the-snowpear/fridge_spirit/doc/野火小智【姿态传感器_MPU6050】模块_20260206/2-配套例程_接线说明/野火小智STM32F103C8核心板/HAL库/3.上位机显示DMP解算/Doc/readme.txt

/*********************************************************************************************/
【*】程序简介

-工程名称：MPU-6050使用上位机
-实验平台: 野火小智 STM32 F103C8T6 核心板

使用MPU-6050采集加速度、角速度、欧拉角等数据，并上传到“匿名上位机”进行姿态显示

/*********************************************************************************************/
【*】实验操作与注意事项：

实验操作

1.核心板掉电情况下，将模块引出脚按照xxx引脚连接说明.xlsx，接到板子对应脚上
2.确保引脚对应接上的情况下，核心板上电，将例程编译成功后，下载到核心板里
3.核心板的USB转串口通过数据线连接电脑，同时确保电脑安装了串口驱动并能识别到核心板的串口
4.电脑端使用串口调试助手，选择电脑与核心板相连的COM口，设置为115200-N-8-1并打开
5.复位核心板，即可接收核心板串口发送给电脑的数据
6.查看串口调试助手打印的提示信息
7.但是本次实验不能直接通过查看串口助手打印的数据来得到有效信息，因为用到了上位机——“匿名上位机V7”，串口传来的数据都根据上位机的数据协议包装过的，
代码烧录完成后，连接串口至电脑端，在文件夹.\1-硬件资料_参考资料_模块手册\例程工具上位机中可以找到 匿名上位机V7.exe，
双击打开软件，可以看见有四个大的板块，分别为：基本收发、协议解析、数据波形、飞控数据，
复位核心板，待LED闪烁后，点击右下角的“连接设置”配置串口的相关参数，串口号直接使用自己的相应串口号即可（可以通过设备管理器查看），波特率实验例程设置的是115200，
配置完成后点击右下角的“打开连接”，当查看到接收计数有增长时，随后点击右下角“功能界面”后面的第四个图标（类似于一个小飞机），也就是飞控数据，可以看到左侧有个3D无人机，右侧是各项参数，
至此就可以看到3D无人机和右侧数据根据MPU6050的姿态变化而变化

注意事项
1.本程序必须配合“匿名上位机V7”使用！！串口向上位机传输的是数据包，所以直接用串口调试助手看是乱码，这是正常的！！
2.MDK工程配置C/C++选项中必须勾选“C99 Mode”选项(本工程默认已勾选，MDK默认不勾选的)
3.因为没加磁力计，六轴MPU6050在Z轴上的测量信息并不准确，同时因为不能完整的使用XYZ三个轴，可能导致Z轴的误差越来越大
4.MPU6050的AD0引脚默认接GND，地址为0x68 ,当接3V3时，地址改为0x69，可在mpu6050.h文件修改宏MPU6050_SLAVE_ADDRESS的值来匹配硬件连接
5.默认使用软件I2C，可在mpu6050.h文件中注释掉#define  soft_IIC使用硬件I2C

/*********************************************************************************************/
【*】引脚分配

MPU-6050：

		3V3 <--->3V3
		GND	<--->GND
		SDA	<--->PB11
		SCL	<--->PB10
		INT <--->PA11
		AD0 <--->GND

LED：
        LED1<--->PA1
        LED2<--->PA2
        LED3<--->PA3
		
串口（TTL-USB TO UART）：
CH340的收发引脚与STM32的发收引脚相连
        CH340  RXD  <--->  USART1  TX  (PA9)
        CH340  TXD  <--->  USART1  RX  (PA10)

/*********************************************************************************************/
【*】联系我们

-野火官网  :https://embedfire.com
-野火论坛  :http://www.firebbs.cn
-野火天猫  :https://yehuosm.tmall.com
-野火京东  :https://yehuo.jd.com/
-野火资料下载中心 :https://doc.embedfire.com/products/link/

/*********************************************************************************************/
