the-snowpear/fridge_spirit/doc/P4_TR230S_SPI4WIRE_FT6336U接线方案.md

# ESP32-P4 CB V1.2 → TR230S SPI-4WIRE + FT6336U 接线方案

> **已停用（2026-07-11）**：同一块屏幕在 S3 上实际验证的是 QSPI-4SDA，接口模式由屏内 IM0/IM1 硬件配置决定。本方案不再用于上电测试，请改用 `doc/P4_TR230S_QSPI_FT6336U接线方案.md`。

适用硬件：慧勤智远 ESP32-P4 CB V1.2、TS040HDS02CP-B1620A（TR230S + FT6336U）、20-pin FPC 转 20 路杜邦线转接板。

> 严禁把屏幕 FPC 直接插进开发板板载 20-pin SPI 屏座。两者电源脚顺序不同，直插会把 5V 接到屏幕 GND。板载 20-pin 屏座保持空置，本方案只把 FPC 转接板的每一路单独接到开发板底部 GPIO 排针。

## 逐脚接线表

开发板一栏使用实板丝印（`07` 表示 GPIO7），不使用原理图连接器代号。FPC Pin 1 必须按转接板丝印或万用表通断确认，不能凭排线正反面猜测。

| FPC Pin | 屏幕信号 | 接开发板丝印 | GPIO | 说明 |
| ---: | --- | --- | ---: | --- |
| 1 | GND | `GND` | — | 公共地 |
| 2 | VCC | `5V` | — | 屏幕主电源，只能接 5V |
| 3 | GND | `GND` | — | 公共地 |
| 4 | CS# | `07` | 7 | SPI 片选，低有效 |
| 5 | GND | `GND` | — | 公共地 |
| 6 | SDO1 / MISO | `10` | 10 | 屏幕到主控；当前驱动只写，但按规格保留连接 |
| 7 | SDO0 / MOSI | `08` | 8 | 主控到屏幕 |
| 8 | SCL / SPI_CLK | `09` | 9 | SPI Mode 0，首次 10 MHz |
| 9 | SDO3 | **不接** | — | 仅 QSPI 使用 |
| 10 | SDO2 | **不接** | — | 仅 QSPI 使用 |
| 11 | RESET# | `22` | 22 | 屏幕复位，低有效 |
| 12 | WAIT# | `19` | 19 | 屏幕忙状态；高电平才允许发送命令 |
| 13 | QSPI-INT / HOST | **不接** | — | 主控直接读 FT6336U，不走 TR230S 触摸代理 |
| 14 | D/C# | `20` | 20 | 低=命令，高=参数/像素 |
| 15 | TP-INT | `15` | 15 | FT6336U 触摸中断 |
| 16 | TP-SDA | `17` | 17 | 触摸 I²C SDA；注意不是 GPIO16 |
| 17 | TP-SCL | `16` | 16 | 触摸 I²C SCL；注意不是 GPIO17 |
| 18 | TP-RST | `18` | 18 | 触摸复位，低有效 |
| 19 | TP-VCC | **不接、悬空** | — | 模组规格标注 `NC (Shared screen power supply)`；禁止接 5V |
| 20 | TP-GND | `GND` | — | 触摸公共地 |

FPC Pin 1、3、5、20 都是 GND。建议在面包板或转接板公共地排汇合，再用至少两根短 GND 线接开发板的两个 `GND`，降低屏幕电流和 SPI 回流造成的地弹噪声。

## I²C 上拉与线长

- `TP-SDA` 和 `TP-SCL` 各接一只 `4.7 kΩ` 电阻到开发板 `3V3`；如果转接板已经带 3.3V 上拉，不重复并联。
- 上拉只能到 `3V3`，不能到 `5V`。`TP_VCC` 保持悬空与 I²C 上拉是两件事。
- 杜邦线尽量不超过 10 cm，SPI 时钟、MOSI、D/C、CS 和相邻 GND 尽量短。
- 首次测试固定 SPI Mode 0 / 10 MHz、触摸 I²C 100 kHz；稳定前不提速。

## 上电顺序

1. 完全断电并拔掉 USB；确认开发板板载 20-pin 屏座为空。
2. 用万用表逐线核对“FPC Pin → 转接板端子 → 杜邦线末端”，尤其确认 Pin 1、Pin 2 和 Pin 19。
3. 检查 5V 与 GND 不短路，各 GPIO 不与 5V 短路；确认所有地共地。
4. 接好后使用稳定 5V/2A 供电。出现异味、异常发热、反复复位或电压塌陷立即断电。
5. 固件日志应先出现 `TR230S display ready`，触摸应出现 `FT6336U ready addr=0x48`；触摸屏时串口打印按下/抬起坐标。

当前 P4 最小固件只用静态色带与串口坐标验证显示/触摸硬件，尚未把旧 S3 的完整 LVGL 页面迁移到 P4。
