the-snowpear/fridge_spirit/ui-reference/ver2/README.md

# 冰箱小精灵 ver2 · UI 参考预览（ESP32-P4 · 横/竖双模式）

本目录是「冰箱小精灵」下一代设备 UI 的**网页参考预览**，完整实现 `doc/` 规划文档定义的
**30 个页面模板 + 12 个全局浮层 + 8 种状态侧舱情境（CTX）**，供设计走查与固件 LVGL
实现对照使用。

- 目标设备：慧勤智远 ESP32-P4 CB V1.2 + 7 寸 1024×600 MIPI-DSI 横屏 + GT911 触摸
- **双模式外壳**（同一套页面/浮层，仅外壳重排）：
  - **横屏标准** `1024×600`：主区 704 | 导航 72 | 状态舱 248（摄像头可用）
  - **竖屏隐私** `600×1024`：上主区 672 / 中导航 64 / 下状态舱 288（**绑定隐私模式，摄像头关闭**；底舱为顶状态条 + 紧凑 CTX）
- 固件 GUI：LVGL 9.2.2（RGB565），字库角色 18/22/28/36/48/64（TF 卡字体包 + FreeType 回退）
- 权威输入：`doc/冰箱小精灵_ESP32-P4_LVGL页面架构与交互规划_V1.0.md`、
  `doc/冰箱小精灵_UI页面路由与状态清单_V1.0.json`、`doc/冰箱小精灵_页面样式设计交接提示词_V1.0.md`
- 视觉风格：暖色 + 鼠尾草绿（延续 ver1 调色板；布局为 ver2 全新三栏壳，与 ver1 方屏无关）
- Web 运维面板：侧栏 **UI 预览** 可 iframe 嵌入本目录，并切换横/竖（Vite 路径 `/ui-ver2/`）

---

## 一、打开方式

**直接双击 `index.html`** 即可（零依赖：无构建、无 ES Module、无 fetch、无 CDN、无网络字体，
`file://` 下完全可用）。也可以起本地服务：

```bash
cd ui-reference/ver2
python -m http.server 8000     # 然后访问 http://localhost:8000
```

或从项目 Web 面板进入：

```bash
cd web
npm run dev
# 浏览器打开面板 → 侧栏「UI 预览」→ 切换「横屏标准 / 竖屏隐私」
```

Query 深链（供 iframe / 书签）：

- `index.html?layout=landscape` 横屏标准
- `index.html?layout=portrait` 竖屏隐私

推荐 Chrome / Edge 最新版。断网可开，控制台应无任何错误。

## 二、预览工具栏（设备框之外，不属于设备 UI）

| 区 | 控件 | 说明 |
| --- | --- | --- |
| 第一行 | 设备预览 / 页面总览 | 设备预览 = 1:1 交互原型；页面总览 = 全部页面/浮层/CTX 缩略图墙 |
| | **布局：横屏标准 / 竖屏隐私** | 切换外壳；竖屏 = 隐私模式（关摄像头） |
| | 页面下拉 + ‹ › | 按模块分组的页面跳转，按规范顺序翻页 |
| | 状态 | 正常 / 加载中 / 空 / 离线 / 错误 / 待确认 / 冲突（六态演示，作用于当前页的异步内容区） |
| | 侧舱 | 自动跟随 或手动锁定 CTX-01..08 |
| | 缩放 | 适应窗口 / 100%（100% 时舞台精确对应当前布局物理像素） |
| | 页面角标 | 页头显示 INV-01 这类规范 ID（默认开，便于与 JSON 清单对照） |
| | 返回 | 先关浮层 → 模块内上一级 → 模块根页（同 Esc 键） |
| 第二行 | OV 触发按钮 ×12 | 逐个演示 12 个全局浮层（标注"阻"= 阻塞型） |
| | 流程演示 ×5 | 拍照登记 / 语音登记 / Agent 高风险确认 / 烹饪+计时 / 安全告警，「停止演示」随时中断；**竖屏下「拍照登记」禁用** |

设备内可真实交互：侧导航切模块、INV-01 空间/列表切换与三级下钻、食材行进详情、
对话工具卡进 CHAT-03、烹饪模式上下步、定时器中心、设置分区切换等。

## 三、目录结构

```
ver2/
├── index.html              # 唯一入口（工具栏 + 设备舞台 + 浮层根 + 按序加载脚本）
├── README.md               # 本文档
├── doc/                    # 规划文档（只读输入，未改动）
├── styles/
│   ├── tokens.css          # 设计令牌（色板/字号/间距/圆角/触控尺寸）
│   ├── base.css            # reset / 设备舞台 / 横竖外壳 / 页面骨架 / 工具栏
│   ├── components.css      # 通用组件（对应 js/core/ui.js 的 builder）
│   ├── cabin.css           # 状态侧舱 + CTX-01..08 + 竖屏底舱
│   ├── overlays.css        # OV-01..12 浮层
│   ├── gallery.css         # 页面总览缩略图墙
│   └── pages-<模块>.css     # 各页面模块独有布局（含竖屏窄主区覆盖）
└── js/
    ├── core/               # icons / ui / mode(横竖+隐私) / router / shell / cabin
    │                       # overlays / states / flows / gallery
    ├── data/mock-data.js   # 全量 mock 数据（演示"今天"= 2026-07-22）
    └── pages/pages-<模块>.js # 系统/首页/库存/对话/计划/更多 六个模块的页面注册与流程
```

架构约定：所有 JS 挂 `window.FS`；页面 = 注册表项 + `render(pg)` 渲染函数（返回 HTML 字符串，
与 LVGL"页面容器 + 子对象树"同构）；路由 `#/p/<页面ID>?参数`（file:// 安全、可刷新、可深链）；
侧导航切模块始终进入该模块一级页（不恢复上次子页现场）；侧舱是独立状态机，不随主页面重建。
布局模式 `FS.mode`：`landscape` / `portrait`；`portrait` 强制 `isPrivacy()===true`。

### 竖屏隐私规则（必须可见）

- 状态舱显示 **隐私模式** 芯片；健康区摄像头图标为 `off`。
- 拍照按钮改为「摄像头关」（禁用态），点击 toast 说明。
- 路由拦截 `INV-05` / `INV-06`；流程「拍照登记」不可启动。
- 横屏模式行为与原先完全一致（含拍照登记）。

## 四、设计令牌（styles/tokens.css）

### 色板（设备内一律纯色平铺，RGB565 友好）

| 令牌 | 值 | 用途 |
| --- | --- | --- |
| `--paper` | `#fffdf8` | 主背景（米白纸面） |
| `--surface` | `#ffffff` | 卡片面 |
| `--cream` | `#fff5e5` | 次级填充 / 侧舱底 |
| `--sage` | `#5f8f72` | 主色：按钮 / 选中 |
| `--sage-dark` | `#2f6047` | 深主色：强调文字 / 侧导航底 |
| `--mint` | `#dcefdc` | 浅绿填充 / 选中底 |
| `--tomato` | `#d95745` | 强调红：危险 / 过期 |
| `--yolk` | `#f6bf4f` | 蛋黄：警示（配深字 `--warn-ink #6b4e00`） |
| `--ink` | `#24342d` | 主文字 |
| `--muted` | `#758078` | 次要文字 |
| `--line` | `rgba(47,96,71,.18)` | 分隔线 / 描边 |
| 语义浅底 | `#dcefdc / #fdeecd / #f9e2de / #eceeed / #e2edf5` | ok / warn / danger / offline / info 五档 chip·banner 底 |

### 字号 / 间距 / 圆角 / 触控

| 项 | 值 | 说明 |
| --- | --- | --- |
| 字号 | **18 / 22 / 28 / 36 / 48 / 64** | 严格对应固件 font_manager 六档字库角色，禁止其他值 |
| 间距 | 4 / 8 / 12 / 16 / 24 / 32 | 4 的倍数 |
| 圆角 | ≤8px（胶囊 = 全圆角） | LVGL 友好 |
| 触控 | 最小 48px；导航/侧舱大按钮 64px | 规划文档要求 44–48px 起 |
| 外壳（横） | 主区 704 + 侧导航 72 + 状态侧舱 248 = 1024；高恒 600 | 系统页隐藏导航（主区 776），OV-10 全屏接管 |
| 外壳（竖） | 宽 600；高 = 主区 672 + 导航 64 + 状态舱 288 = 1024 | 竖屏 = 隐私模式；底舱顶条+紧凑 CTX；系统页隐藏导航 |

## 五、组件 → LVGL 映射

| 预览组件（class） | 用途 | LVGL 对应 |
| --- | --- | --- |
| `.btn` / `.icon-btn` | 操作按钮 | `lv_btn` + 样式 |
| `.card` / `.stat-card` | 信息卡 / 统计卡 | `lv_obj` 圆角容器 |
| `.list-row` / `.food-row` | 列表行 / 食材行 | `lv_obj` 行（LV_FLEX） |
| `.chip` / `.days-pill` | 标记 / 剩余天数 | `lv_obj` + `lv_label` |
| `.seg` | 分段选择（空间/列表、日/周） | `lv_obj` 分段（互斥选中） |
| `.badge` / `.status-dot` | 角标 / 状态点 | `lv_label` 圆底 / `lv_obj` 小圆 |
| `.crumb` | 路径面包屑 | `lv_label` 行 |
| `.zone-map` / `.layer-card` | L1 分区图 / L2 层卡（共用 `.tone-*` 语义底色 + `.sp-bar` 色条） | `LV_GRID` / `lv_obj` 行 |
| `.grid9-board` / `.g9-cell` | L3 九宫格（ver1 风格：一块大圆角板 + 发丝线切九格） | 一个 `lv_obj`（圆角+裁剪）+ 九个子 `lv_obj`，分隔线用子对象右/下 1px 边框 |
| `.g9-expire` | 格内到期条（颜色 = 该格最紧急项的剩余天数档） | `lv_obj` 圆角条 + `lv_label` |
| `.fridge-box` | 冰箱内胆外框（包住当前层级的空间，顶部给范围汇总） | `lv_obj` 容器 + 标题行 |
| `.inv-lay-grid` / `.inv-name-panel` | INV-08 分区形状画布 / 命名面板 | `LV_GRID` / 页面内子容器 |
| `.chat-bubble` / `.tool-card` / `.result-card` | 对话流 | `lv_obj` 容器族 |
| `.recipe-card` / `.menu-slot` | 菜谱 / 餐次 | `lv_obj` 族 |
| `.timer-face-sm` / `.ctx-timer-face` | 计时数字 | `lv_label` + `lv_timer` 局部刷新 |
| `.form-row` / `.switch` / `.stepper` / `.input-like` | 表单 | `lv_obj` / `lv_switch` / `lv_btn` |
| `.kb` / `.roller` | 软键盘 / 滚轮选择器 | `lv_keyboard` / `lv_roller` |
| `.skeleton` / `.empty-state` / `.notice-bar` / `.conflict-box` | 异步状态 | 静态灰块 / `lv_obj`+`lv_label`（固件不做 shimmer 动画） |
| `.kaomoji`（SYS-03） | 待机颜文字 | `lv_label` 大字（纯文本，不依赖图片资源） |
| `.health-icon` / `.ctx-panel` | 侧舱健康图标 / CTX 面板 | `lv_obj` + 小图标 |
| `.scrim` / `.toast` / `.dialog` / `.sheet` | 浮层基元 | `lv_obj` 顶层 + `bg_opa` |
| `.img-ph` | 图片占位块 | TF 卡图片缺失时的占位 `lv_obj` |

## 六、页面 / 浮层 / 侧舱清单（与 JSON 清单逐项对应）

### 30 个页面模板

| 模块 | 页面 |
| --- | --- |
| 系统（3） | SYS-01 启动与自检 · SYS-02 首次配网与设备绑定向导（4 步）· SYS-03 待机颜文字 |
| 首页（2） | HOME-01 首页 · HOME-02 今日摘要详情 |
| 库存（7） | INV-01 库存浏览器（空间/列表双视图，L1 分区→L2 层→L3 九宫格，单模板）· INV-03 食材详情 · INV-04 新增/编辑食材 · INV-05 拍照取景与拍摄 · INV-06 识别结果确认 · INV-07 搜索与筛选结果 · INV-08 空间形状编辑（按入口层级打开分区、指定分区的层、指定层设置三个独立页，画布点选+草稿提交） |
| 对话（4） | CHAT-01 对话主页面 · CHAT-02 会话历史 · CHAT-03 工具执行详情 · CHAT-04 待确认行动 |
| 计划（6） | PLAN-01 计划总览 · PLAN-02 日/周菜单 · PLAN-03 菜谱库 · PLAN-04 菜谱详情 · PLAN-05 烹饪模式 · PLAN-06 购物清单 |
| 更多（8） | MORE-01 更多入口（可滚动）· MORE-02 定时器 · MORE-03 定时器/闹钟编辑 · MORE-04 设备与厨房安全 · MORE-05 设置中心 · MORE-06 维护中心 · MORE-07 闹钟 · MORE-08 秒表 |

### 12 个全局浮层

OV-01 轻提示 Toast（非阻塞，2.5s 自消）· OV-02 顶部/区域通知条（非阻塞）·
OV-03 通用确认框（**阻塞**）· OV-04 Agent 高风险操作确认（**阻塞**）·
OV-05 语音聆听与转写层 · OV-06 Agent 处理状态层 · OV-07 拍照上传与识别进度 ·
OV-08 同步/离线状态层 · OV-09 定时器/闹钟到时层 · OV-10 关键安全告警（**阻塞 + 全屏接管，P0**）·
OV-11 快速添加面板 · OV-12 软键盘/数值与日期选择器（**阻塞**，停靠主区底部）

### 8 种状态侧舱情境（CTX）

CTX-01 默认/首页 · CTX-02 库存 · CTX-03 语音 · CTX-04 拍照识别 ·
CTX-05 Agent 执行 · CTX-06 计划/烹饪 · CTX-07 定时器 · CTX-08 异常/安全。
侧舱"自动跟随"按 浮层 > 页面 的优先级映射切换，也可由工具栏手动锁定。

## 七、LVGL 保真规范（本预览自查依据，固件实现对照）

1. 设备舞台内全部固定 px（与设备 1:1），外壳恒为 704/72/248 × 600，禁 vw/vh。
2. 布局只用 flex/grid → 对应 `LV_FLEX` / `LV_GRID`，无浮动/定位技巧。
3. 禁 backdrop-filter 与大面积模糊；遮罩 = 纯色 `rgba(36,52,45,.55)`（`lv_obj` + `bg_opa`）；
   阴影仅浮层小阴影（≤8px），固件以 1px 描边替代。
4. 圆角 ≤8px；字号仅 18/22/28/36/48/64 六档。
5. 动画仅 opacity/transform、≤200ms、可中断；无大面积循环动画。
   例外说明：OV-05 麦克风呼吸圈为预览表现，固件用静态帧或低频局部刷新；
   计时数字在预览中为静态 mock，固件用 `lv_timer` 1s 局部刷新。
6. 不依赖悬停：hover 仅是增强，所有操作有可见按钮；触控目标 ≥48px。
7. 图标 = 内联 SVG 单色（对应固件 TF 卡 PNG/字形资源），图标位均有文字标签可回退；
   图片一律 `.img-ph` 占位块（对应 TF 卡资源缺失回退策略）。
8. 滚动区统一 `.scroll-area`（= LVGL 可滚动容器），禁嵌套滚动。
9. 颜色纯色平铺、RGB565 友好；语义色克制为 ok/warn/danger/offline/info 五色。
10. 几何例外显式化：SYS 系统页隐藏侧导航（主区 776）、OV-10 全屏接管（P0）——
    对应固件 Page Manager 的特殊页类型。

## 八、与规划文档的对应解读（实现时做的一致化决定）

- **系统页侧舱简化**：规范要求"三部分始终同时存在；系统页面与关键告警除外"。本预览对
  SYS-01/02/03 隐藏 72px 侧导航，侧舱分别降级为 自检摘要 / 向导进度 / 仅时间温湿度。
- **INV-01 单模板**：3 层级 × 2 视图共用一个渲染函数，由 URL 参数（zone/layer/cell/view）驱动；
  页面总览中为 INV-01 出 5 张变体（根空间 / 分区空间 / 九宫格空间 / 根列表 / 分区列表）。
- **三级空间共用一套视觉语言**：L1 分区块 / L2 层卡 / L3 格子都按"范围内最差食材"上语义色
  （`ui.freshTone()` 直接复用 `dataQ.daysTone` 阈值：过期或今天到期=红 / 3 天内临期=黄 /
  都还富余=绿 / 空=灰），用户在任一层级都用同一套颜色判断"哪里要先处理"。
  L1/L2 是"语义浅底 + 左侧 4px 色条 + 大号项数"；L3 沿用 ver1 风格（见下条）。
- **L3 九宫格沿用 ver1 视觉**：一整块大圆角板用发丝线切成九格（不是九张独立卡片），
  每格自上而下 = 位置名·格号（内/中/外 × 左/中/右）/ 食材名 + 数量 / 整格宽到期条。
  每格严格只存放一项食材；点击已占用格直接进入该食材的 INV-03，点击空格直接进入已预填位置的 INV-04。
  L3 不套内胆卡头（层名已在页头副标题与面包屑里），整块高度让给九宫格以容下上述信息。
- **九宫格不做合并位**：L3 恒为 A1–C3 九个等大单位格。规划文档提到的"相邻格合并"在本版本
  被取消——合并会让位置模型、食材 `loc.cells` 与布局编辑都复杂一档，而收益只是一个自定义位名。
  因此 INV-08 只编辑"形状"（分区矩形 + 层）；第三级仅展示固定九宫格规则。
- **INV-08 按入口层级分成独立页**：从库存 L1、L2、L3 分别进入分区形状、指定分区层结构、指定层设置；
  不在编辑页内显示标签栏或分区芯片，返回始终回到进入前的位置。
  命名不强制走软键盘：常用名/类型做成预置芯片一点即改（仍保留 OV-12 键盘入口）。
- **删除前引导迁移而非拒绝**：分区/层里还有食材时，确认框直接给"去查看"，跳到该范围的库存
  列表（`INV-01?zone=..&view=list`），对应规范"保存前迁移受影响食材"。
- **INV-05 不开真实摄像头**：预览用静态取景框（隐私考虑 + file:// 限制），快门按钮触发
  "拍照登记"流程演示（INV-05 → OV-07 → INV-06 → 确认 → toast）。
- **识别结果不落库**：INV-06 的所有操作都止步于"确认/待确认/取消"的演示反馈，
  对应规范"识别结果需确认后才会写入库存"。
- **mock 数据**：演示"今天"锚定 2026-07-22（`js/data/mock-data.js` 的 `TODAY`），
  食材字段对齐固件库存模型（name/qty/unit/expire/daysLeft/loc{zone,layer,cells}/source/confidence）。

## 九、验收清单

- [ ] 双击 `index.html` 可打开（file://）；断网无控制台错误、无外部资源请求。
- [ ] 全部页面均可经 侧导航 / 页面下拉 / 页面总览 到达，页头角标 ID 与清单一致。
- [ ] INV-01 演示五态（L1 根空间 / L2 分区空间 / L3 九宫格空间 / 根列表 / 分区列表）；
      空间/列表切换常驻顶部，切换不丢 scope，返回恢复现场。
      三级共用同一套新鲜度语义色（过期/今天到期=红 / 3 天内临期=黄 / 富余=绿 / 空=灰），
      L1 与 L3 撑满主区不滚动；L3 为 ver1 风格大板九格，每格含食材名+数量+到期条。
      冰箱图标常驻在顶部范围信息条最左（空间/列表视图都可见）。
      已占用格直接进入食材详情，空格直接进入预填位置的新增页；选位流程禁用已占用格。
- [ ] INV-08 三个独立编辑页：**分区形状**（先进入新增模式，再在 3×3 空位画矩形、改名/类型、删除）、
      **指定分区层结构**（添加层、点层进入设置）和 **指定层设置**（改名、删除、固定一格一项规则）；
      九宫格恒为 A1–C3 不可编辑，因此本页没有第三级；编辑先入草稿，提交写回 mock layout；
      分区/层里还有食材时不直接拒绝，而是引导到对应库存列表去迁移。
- [ ] 12 个浮层全部可触发；阻塞层有遮罩且拦截下层；返回键先关浮层再退页；OV-10 全屏抢占。
- [ ] 8 个 CTX 可自动跟随与手动锁定；侧舱语音/拍照大按钮常驻（系统页除外）。
- [ ] 状态切换器在代表页演示 加载中 / 空 / 离线 / 错误 / 待确认 / 冲突 六态。
- [ ] 100% 缩放下横屏舞台精确 1024×600（704+72+248）；竖屏精确 600×1024（上 672 / 中 64 / 下 288）；工具栏在设备框之外。
- [ ] 竖屏计划页可完整滚动查看「本周菜单」与 Agent 卡，不被导航切腰；状态舱 CTX 主操作按钮可见。
- [ ] 工具栏可切换横屏标准 / 竖屏隐私；竖屏可见隐私芯片与「摄像头关」，无法进入拍照登记。
- [ ] Web 面板「UI 预览」可嵌套显示并切换布局（`/ui-ver2/`）。
- [ ] 5 条关键流程在横屏可端到端走通（拍照登记 / 语音登记 / Agent 高风险确认 / 烹饪+计时 / 安全告警）。
- [ ] 全部界面文案为简体中文；代码注释中文；文件 UTF-8 无 BOM；未改动 `doc/`。

## 十、固件落地提示

- 页面注册表（`js/core/router.js`）→ 固件 Page Manager 的 route 表；
  侧舱状态机（`js/core/cabin.js`）→ context_controller；浮层栈（`js/core/overlays.js`）→ 顶层 layer 管理。
- 字号六档已对齐 `font_manager` 角色（18/22/28/36/48/64），TF 卡字体包缺失时回退 FreeType/内置字体。
- 颜色可直接取令牌十六进制转 RGB565；浅底五色建议预定义为固件样式常量。
- 图标当前为内联 SVG（描边风格、单色），固件替换为 TF 卡 PNG 或自定义字形，尺寸 22/28/36。
