the-snowpear/fridge_spirit/doc/chat_page_integration.md

# 对话页集成完成报告

## 概述

已成功将 `ui-reference/ver2` 中的对话页（CHAT-01）移植到 ESP32-P4 固件的 LVGL UI 系统中。本次移植完成了数据模型、UI 渲染、页面切换等核心功能，为后续集成本地 agent 系统打下了基础。

## 移植完成时间
2026-07-25 17:04

## 核心成果

### 1. 完整的数据模型层
- 定义了 4 种消息类型（user/agent/tool/result）
- 支持工具调用状态追踪（pending/running/ok/error）
- 实现了风险等级分类（低/中/高）
- 提供了 JSON 解析和默认数据生成函数

### 2. 功能完整的 UI 层
- 实现了用户/Agent 对话气泡（左右对齐、不同配色）
- 实现了工具调用卡（显示工具名、风险等级、执行状态）
- 实现了结果卡（显示 AI 生成的结果摘要）
- 实现了顶部状态栏（权限模式、同步状态、历史入口）
- 实现了底部输入区（常用指令、输入框、语音、发送/停止）

### 3. 页面系统集成
- 添加了 4 个页面枚举（chat/chat_history/chat_tool_detail/chat_pending_actions）
- 集成到页面切换系统（支持 PPA 滚动加速）
- 设置了正确的页面标题和 ID（CHAT-01）

## 技术细节

### 数据结构设计
```c
typedef struct {
    fridge_ui_chat_message_type_t type;
    char text[512];              // 消息文本
    char time[8];                // 时间戳
    char tool_name[32];          // 工具标识
    char tool_label[40];         // 工具显示名
    char tool_detail[128];       // 执行详情
    fridge_ui_chat_risk_t risk;  // 风险等级
    fridge_ui_chat_tool_status_t tool_status; // 工具状态
    // ... 更多字段
} fridge_ui_chat_message_t;
```

### UI 布局
- 主区域：704px 宽
- 消息流：支持纵向滚动，最多 20 条消息
- 气泡宽度：268px
- 工具卡宽度：672px（全宽）
- 输入区高度：100px（固定在底部）

### 颜色方案
- 用户气泡：#3A7BFD（蓝色）
- Agent 气泡：#2A3731（深绿）
- 低风险：#4CAF50（绿色）
- 中风险：#FFA726（橙色）
- 高风险：#FF4444（红色）

## 与 Agent 系统的集成点

### 现有 Agent 组件
- `agent_runtime` - 本地 Agent 运行时
- `agent_storage` - TF 卡存储
- `ai_actions` - 动作执行器
- `ai_client` - AI API 客户端

### 待完成的集成工作
1. **输入处理**：将用户输入路由到 `agent_runtime`
2. **状态同步**：将 Agent Run 状态映射到 UI 消息
3. **工具可视化**：从 trace_json 提取工具调用信息
4. **事件响应**：实现按钮点击、键盘输入、语音输入

## 文件清单

### 修改的文件
1. `components/ui_p4/include/fridge_ui_p4.h` - 添加页面枚举
2. `components/ui_p4/fridge_ui_p4.c` - 添加页面键名映射
3. `components/ui_p4/fridge_ui_model.h` - 添加数据模型定义
4. `components/ui_p4/fridge_ui_model.c` - 实现数据模型函数（~200 行）
5. `components/ui_p4/fridge_ui_shell.h` - 添加 update_chat 函数
6. `components/ui_p4/fridge_ui_shell.c` - 实现对话页渲染（~250 行）

### 备份位置
`tmp/backups/manual/20260725-170419_chat_page_migration/`

### 文档
- `tmp/notes/chat_page_migration_summary.md` - 详细技术文档
- `doc/chat_page_integration.md` - 本文档

## 测试方法

### 1. 编译测试
```bash
powershell -NoProfile -ExecutionPolicy Bypass -Command "cd 'D:\esp-IDF\Project\fridge_spirit_p4'; idf.py reconfigure build"
```

### 2. 烧录测试
```bash
powershell -NoProfile -ExecutionPolicy Bypass -Command "cd 'D:\esp-IDF\Project\fridge_spirit_p4'; idf.py -p COM17 flash"
```

### 3. 功能测试
通过 USB 串口发送页面切换命令：
```json
{"command":"tool_call","request_id":"test001","tool":"ui.switch_page","arguments":{"page":"chat"}}
```

预期结果：
- 屏幕显示 "对话" 页面标题
- 页面 ID 显示 "CHAT-01"
- 显示 3 条示例消息（1 个用户问题 + 1 个工具卡 + 1 个 Agent 回复）
- 底部显示输入区和常用指令

## 后续开发优先级

### 高优先级（必需功能）
1. 实现用户输入 → agent_runtime 集成
2. 实现 Agent 状态 → UI 消息流映射
3. 实现发送/停止按钮逻辑
4. 实现语音输入集成

### 中优先级（增强体验）
1. 实现会话历史页（CHAT-02）
2. 实现工具详情页（CHAT-03）
3. 实现待确认行动页（CHAT-04）
4. 实现消息流自动滚动

### 低优先级（优化功能）
1. 消息流懒加载
2. 工具卡执行动画
3. 会话历史持久化
4. 权限模式切换

## 依赖项检查
- ✅ LVGL 8.x
- ✅ FreeType 字体渲染
- ✅ PPA 滚动加速
- ✅ GT911 触摸驱动
- ✅ IME 输入法（复用 alarm 页）
- ✅ agent_runtime 接口
- ✅ ai_actions 接口

## 内存占用估算
- 数据模型：~32KB（chat_business_model_t）
- UI 对象：~8KB（LVGL 对象树）
- 消息缓冲：~10KB（20 条消息 × 512 字节）
- 总计：~50KB（在 32MB PSRAM 范围内）

## 兼容性说明
- 设计分辨率：1024×600（横屏）
- 目标硬件：ESP32-P4 CB V1.2
- ESP-IDF 版本：5.5.1
- LVGL 版本：8.x
- 字体：Noto Sans CJK SC（FreeType）

## 已知限制
1. 消息数量限制为 20 条（可通过修改 `FRIDGE_UI_CHAT_MESSAGES_MAX` 调整）
2. 单条消息文本限制 512 字节（可扩展）
3. 暂未实现消息流的增量更新（全量重建）
4. 暂未实现二级页面（会话历史、工具详情等）
5. 图标系统尚未绑定 TF 卡 A8 资源

## 代码质量保证
- ✅ 所有函数都有中文注释
- ✅ 遵循项目命名规范
- ✅ 遵循备份工作流
- ✅ 数据结构边界检查
- ✅ 内存安全（使用 strlcpy）
- ✅ UTF-8 编码一致性

## 参考资料
- 原始设计：`ui-reference/ver2/js/pages/pages-chat.js`
- Mock 数据：`ui-reference/ver2/js/data/mock-data.js`
- Agent 接口：`components/agent_runtime/include/fridge_agent_runtime.h`
- UI 主题：`components/ui_p4/fridge_ui_theme.h`

## 结论

对话页的 UI 骨架已完成移植，数据模型设计合理，UI 渲染功能完整。下一步重点是实现用户输入与本地 agent 系统的集成，打通从用户输入到 AI 回复的完整链路。

建议按照 Phase 1（基础交互）→ Phase 2（Agent 集成）的顺序推进，优先实现核心交互功能，再完善二级页面和高级功能。

---
**移植完成人**：Claude (Opus 5)  
**审查状态**：待真机测试  
**集成状态**：UI 层完成，Agent 集成待开发  
**文档版本**：v1.0
