the-snowpear/fridge_spirit/doc/野火小智【姿态传感器_MPU6050】模块_20260206/2-配套例程_接线说明/H750_PRO开发板/HAL库/对应教程例程/1.MPU6050基本数据读取_(软件I2C)/必读说明.txt

/*********************************************************************************************/

【*】 程序简介 
-工程名称：MPU6050基本数据读取
-实验平台: 野火STM32 H750 开发板
-MDK版本：5.25
-ST固件库版本：1.5.0

【 ！】功能简介：
使用MPU6050读取原始加速度、角速度及温度数据。

【 ！】实验操作：
电脑端使用串口调试助手，选择电脑与STM32相连的COM口，设置为115200-N-8-1，
复位开发板，即可接收STM32串口发送给电脑的调试信息。

【 ！！】注意事项：
 跳线帽：彩灯需要用跳线帽连接J73 (出厂默认已连接，J73位置在彩灯附近)

/*********************************************************************************************/
【*】 引脚分配

MPU6050：
MPU6050片的I2C接口与STM32的I2C1相连,且已接上拉电阻。
		SCL	<--->PB8
		SDA	<--->PB9
		本程序中没有使用INT引脚
		
串口(TTL-USB TO USART)：
CH340的收发引脚与STM32的发收引脚相连。
	RX<--->PA9
	TX<--->PA10
	
/*********************************************************************************************/

【*】 时钟

A.晶振：
-外部高速晶振：25MHz
-RTC晶振：32.768KHz

B.各总线运行时钟：
-系统时钟 = SYCCLK = 480MHz
-AHB4 = 240MHz
-AXI  = 240MHz
-APB1 = 120MHz 
-APB2 = 120MHz 
-APB3 = 120MHz
 
C.浮点运算单元：
  使能

/*********************************************************************************************/

【*】 版本

-程序版本：1.0
-发布日期：2019

-版本更新说明：首次发布

/*********************************************************************************************/

【*】 联系我们

-野火论坛    :http://www.firebbs.cn
-淘宝店铺    :http://firestm32.taobao.com

/*********************************************************************************************/
