the-snowpear/fridge_spirit/doc/燃气传感器/MQ转直插圆板焊接说明.pdf

## 本商品只是转接板，下图中的 3P 单排母座和 3P 排针需要自备。

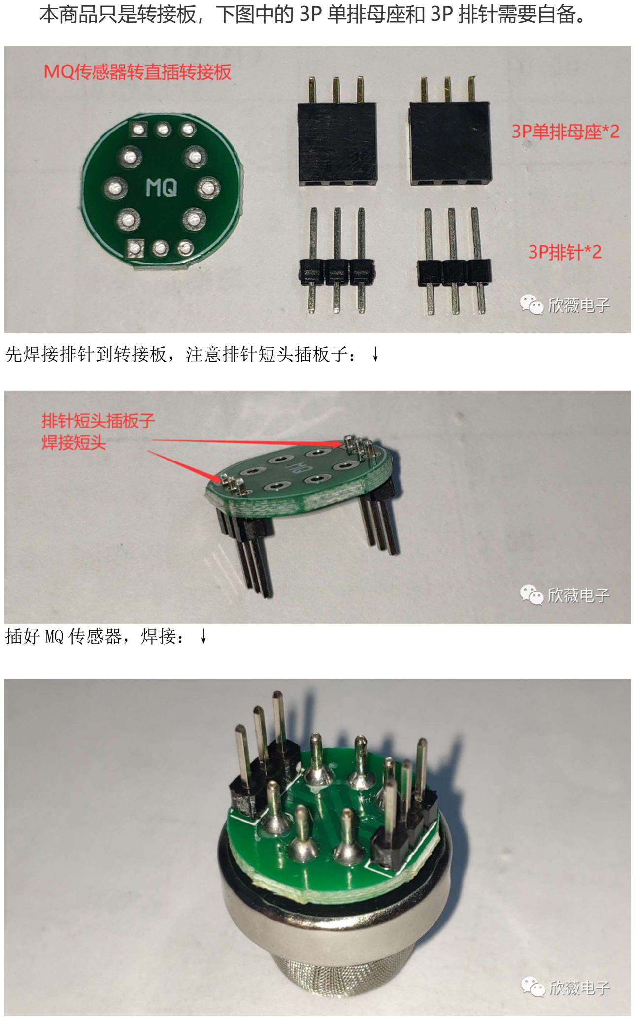
[picture p21: page 1]

先焊接排针到转接板，注意排针短头插板子：↓

插好 MQ 传感器，焊接：↓

将焊接好转接板的传感器插到主板上：↓
主板上可以焊接 3P 单排母座，也可以直接插板子上焊接。

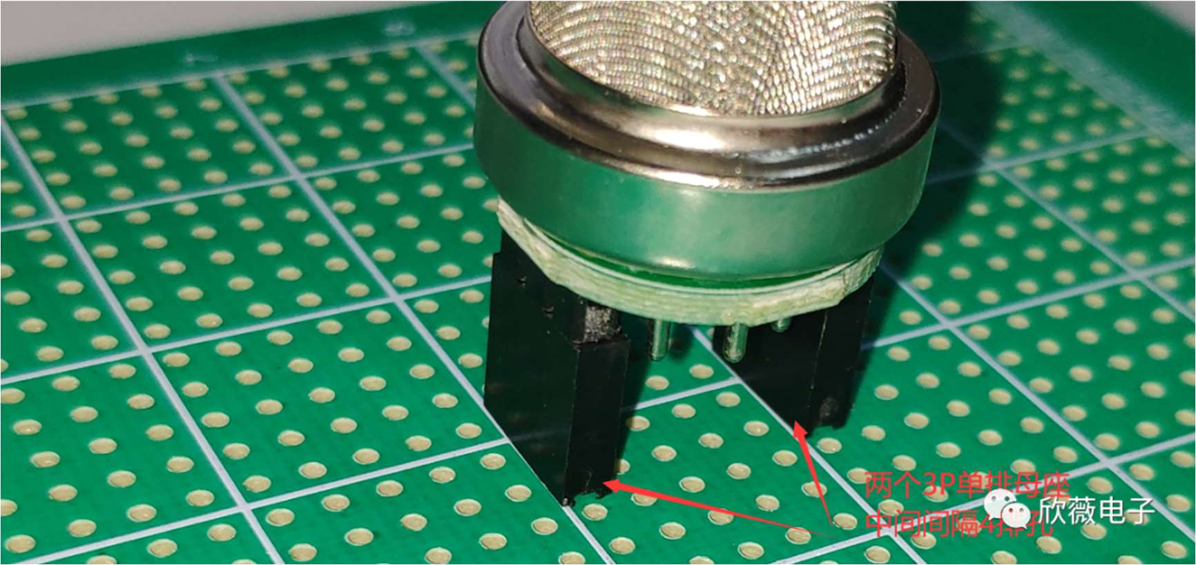
[picture p22: figure]
