the-snowpear/fridge_spirit/doc/野火小智【姿态传感器_MPU6050】模块_20260206/1-硬件资料_参考资料_模块手册/例程工具上位机/匿名上位机V7/上位机简易使用说明.pdf

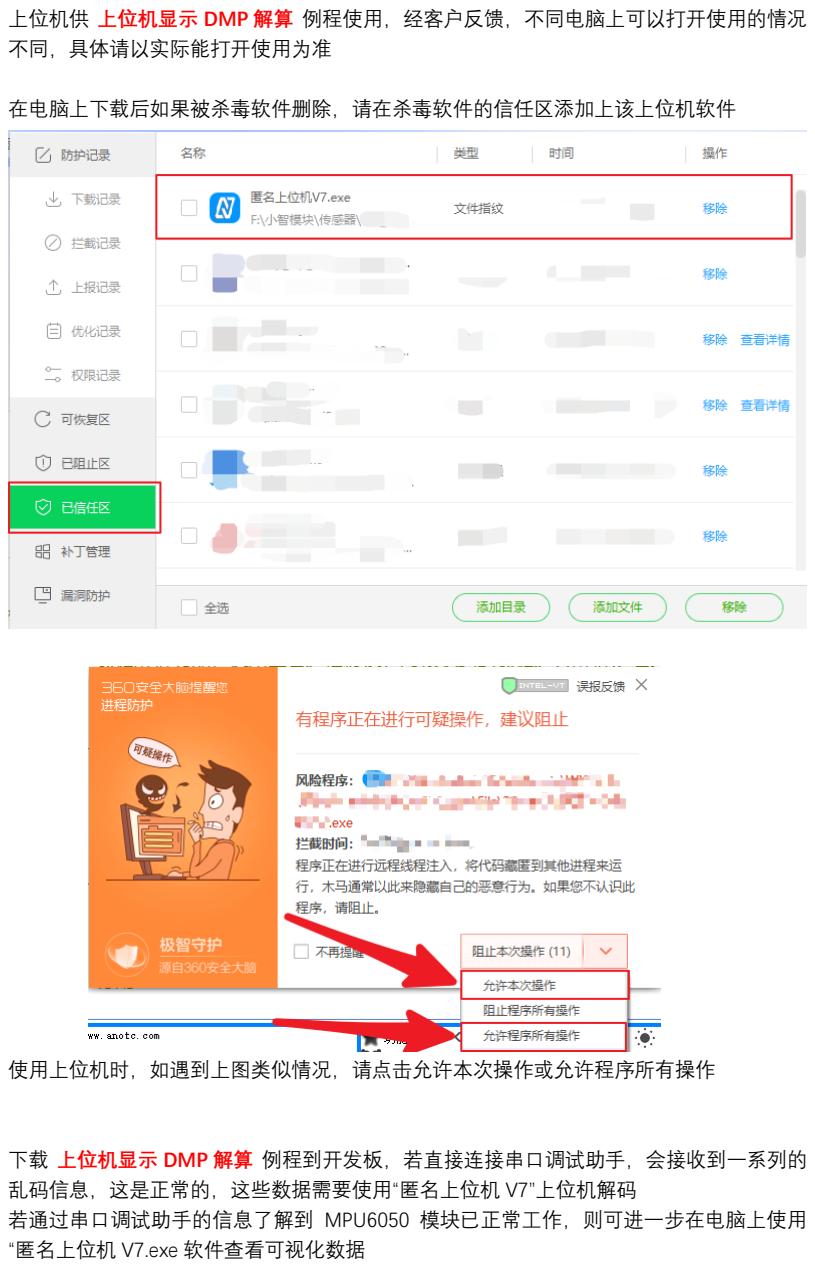
[picture p23: page 1]

上位机供 上位机显示 DMP 解算 例程使用，经客户反馈，不同电脑上可以打开使用的情况 不同，具体请以实际能打开使用为准

在电脑上下载后如果被杀毒软件删除，请在杀毒软件的信任区添加上该上位机软件

使用上位机时，如遇到上图类似情况，请点击允许本次操作或允许程序所有操作

下载 上位机显示 DMP 解算 例程到开发板，若直接连接串口调试助手，会接收到一系列的 乱码信息，这是正常的，这些数据需要使用“匿名上位机 V7”上位机解码 若通过串口调试助手的信息了解到 MPU6050 模块已正常工作，则可进一步在电脑上使用 “匿名上位机 V7.exe 软件查看可视化数据

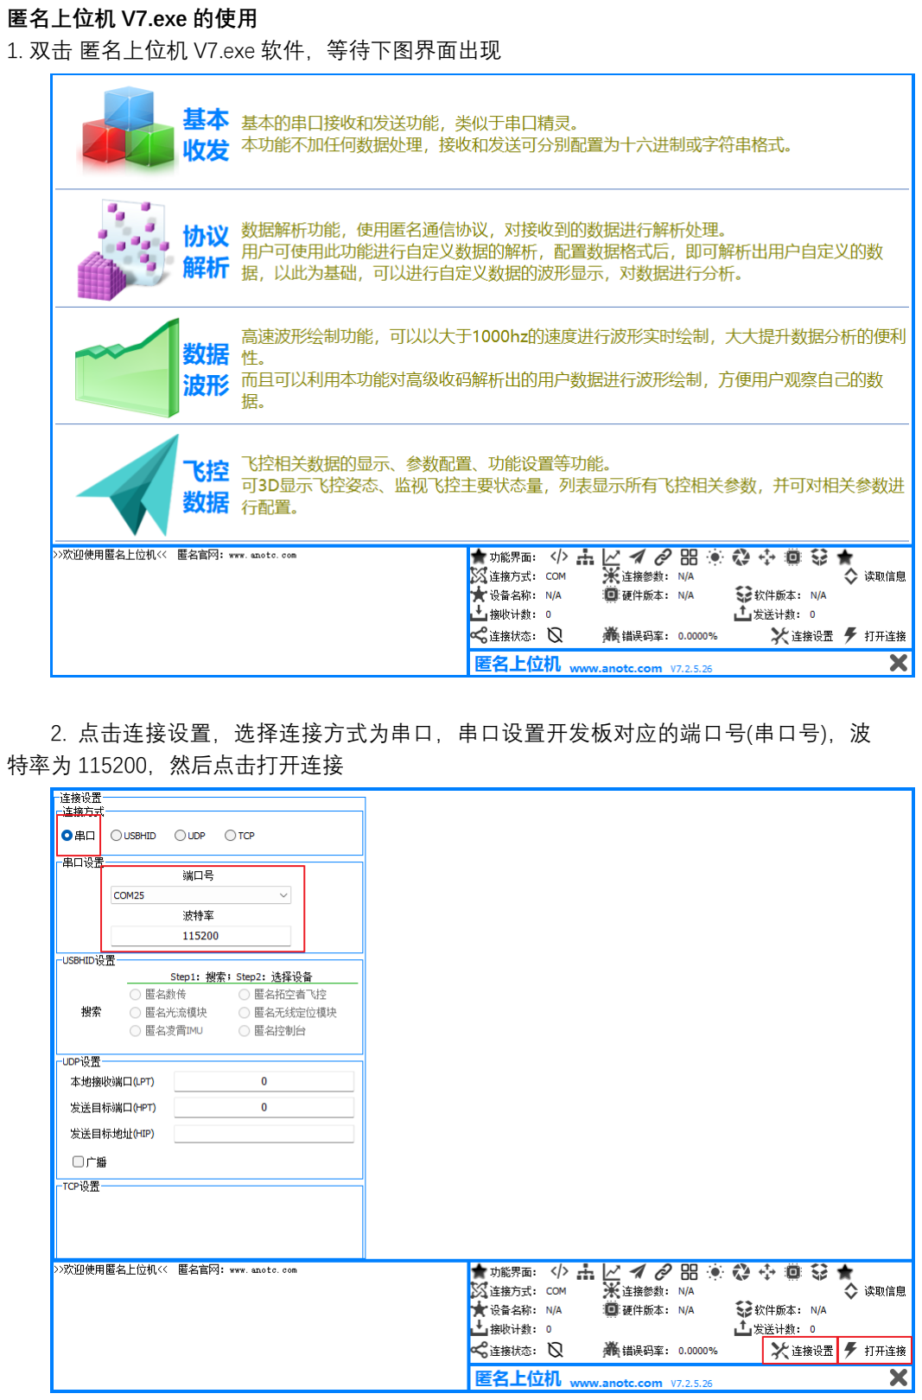
[picture p24: page 2]

匿名上位机 V7.exe 的使用
1. 双击 匿名上位机 V7.exe 软件，等待下图界面出现
2. 点击连接设置，选择连接方式为串口，串口设置开发板对应的端口号(串口号)，波 特率为 115200，然后点击打开连接

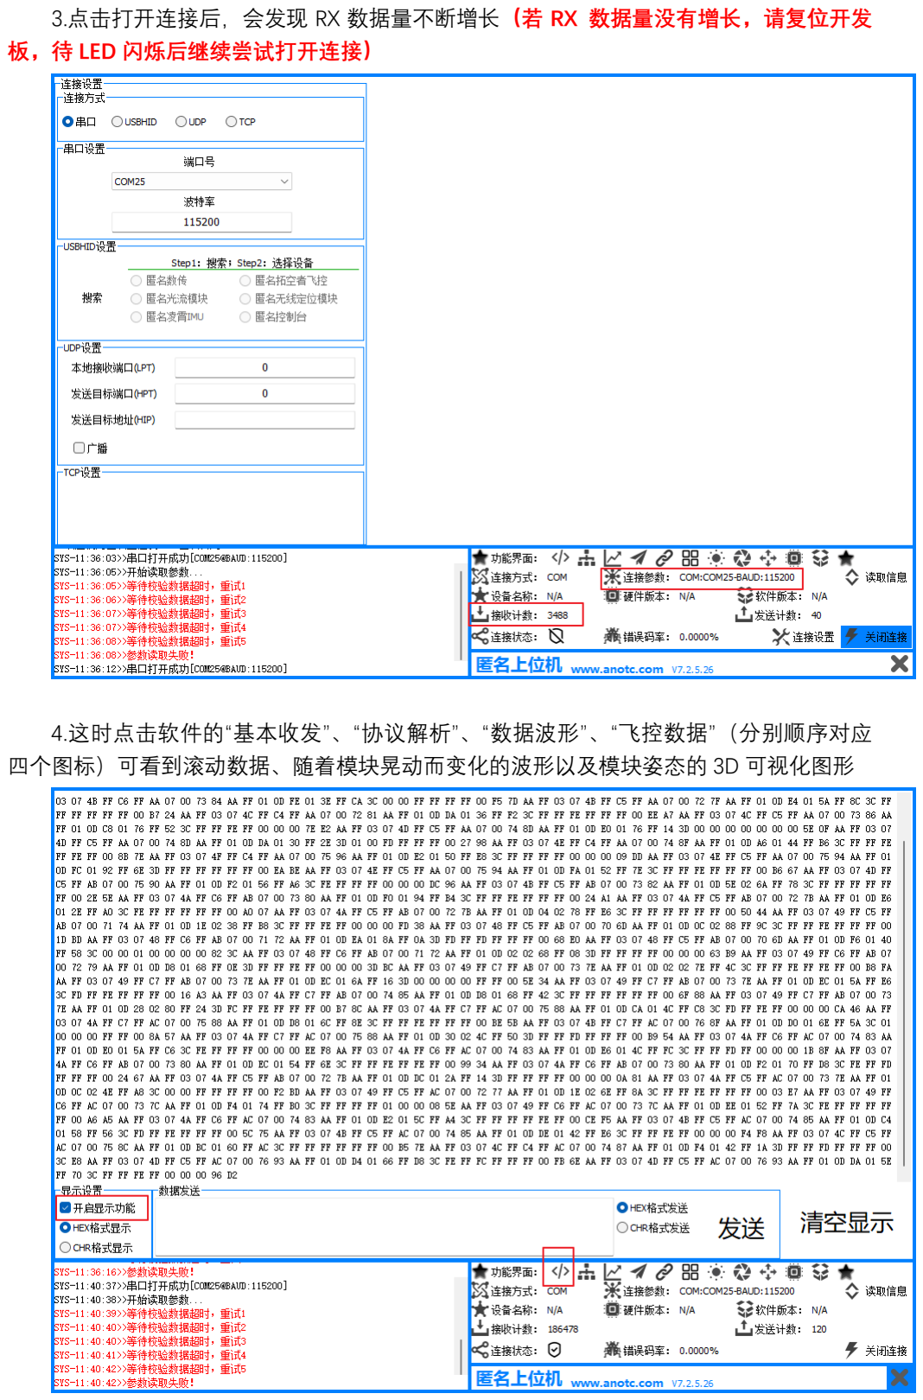
[picture p25: page 3]

3.点击打开连接后，会发现 RX 数据量不断增长（若 RX 数据量没有增长，请复位开发 板，待 LED 闪烁后继续尝试打开连接）

4.这时点击软件的“基本收发”、“协议解析”、“数据波形”、“飞控数据”（分别顺序对应 四个图标）可看到滚动数据、随着模块晃动而变化的波形以及模块姿态的 3D 可视化图形

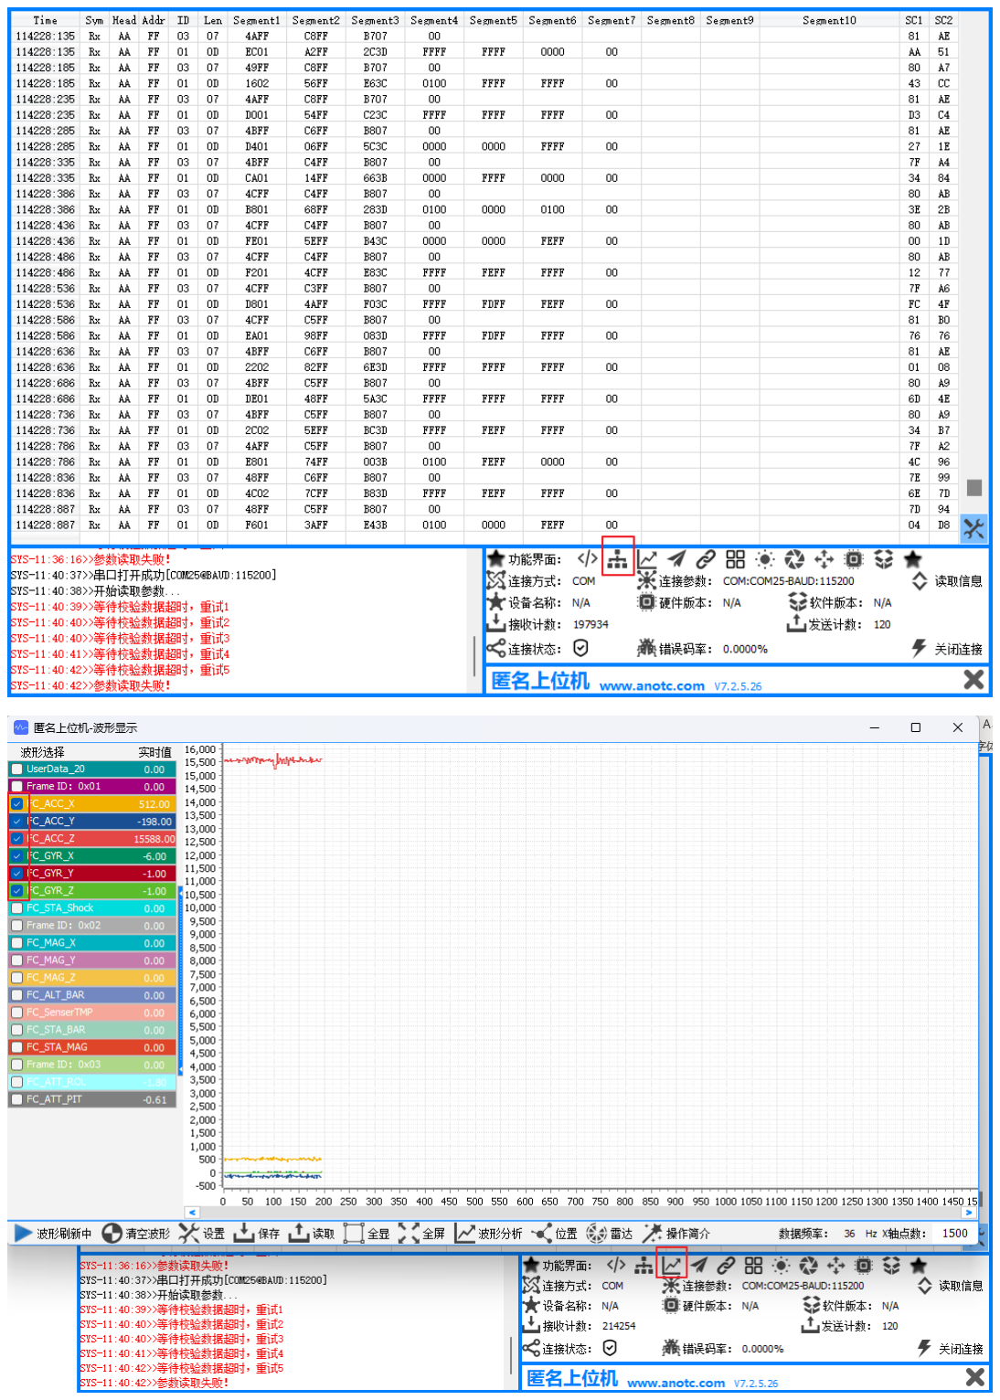
[picture p26: page 4]

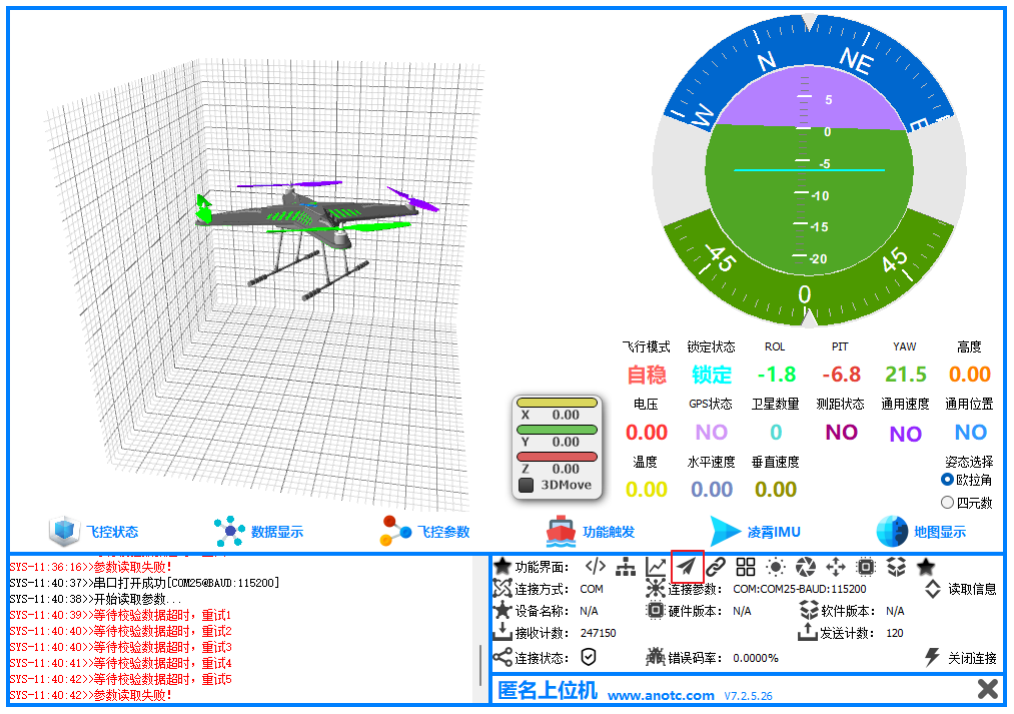
[picture p27: figure]
