the-snowpear/fridge_spirit/doc/野火小智【姿态传感器_MPU6050】模块_20260206/1-硬件资料_参考资料_模块手册/参考资料/第三方资料/姿态解算资料/飞行控制系统.pdf

中国国防科技网 | http://www.81tech.com

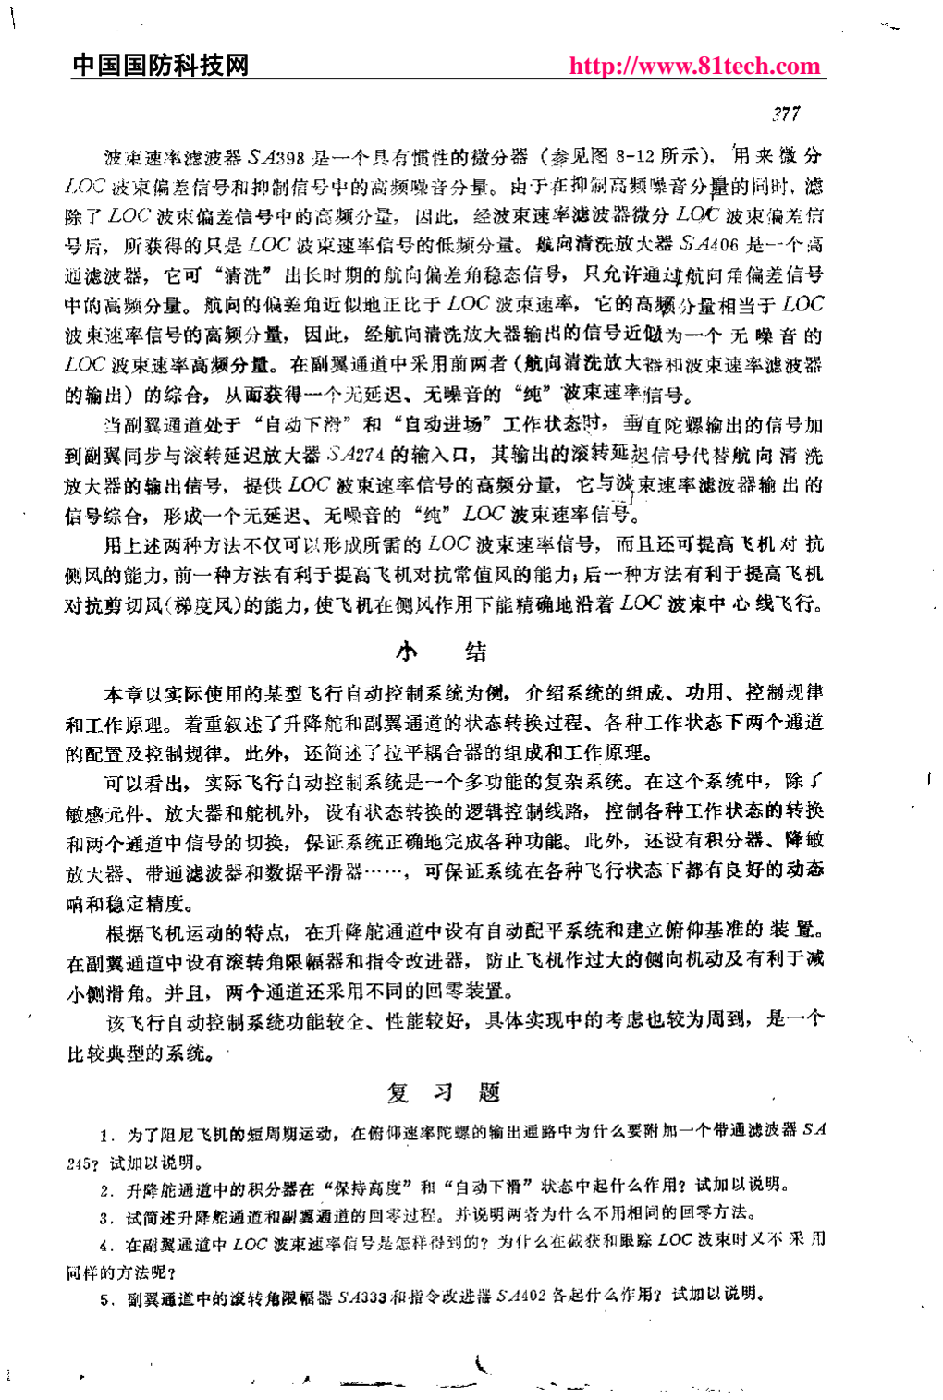
[picture p28: page 380]
