the-snowpear/fridge_spirit/doc/assets/ui-stopwatch.png

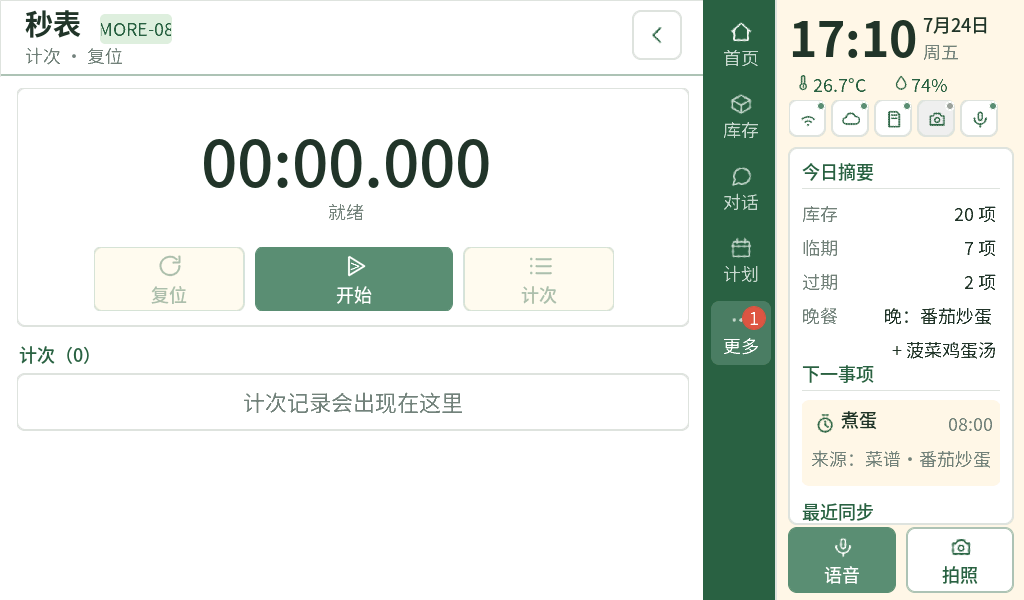
doc/assets/ui-stopwatch.png
