the-snowpear/fridge_spirit/doc/assets/web-console.png

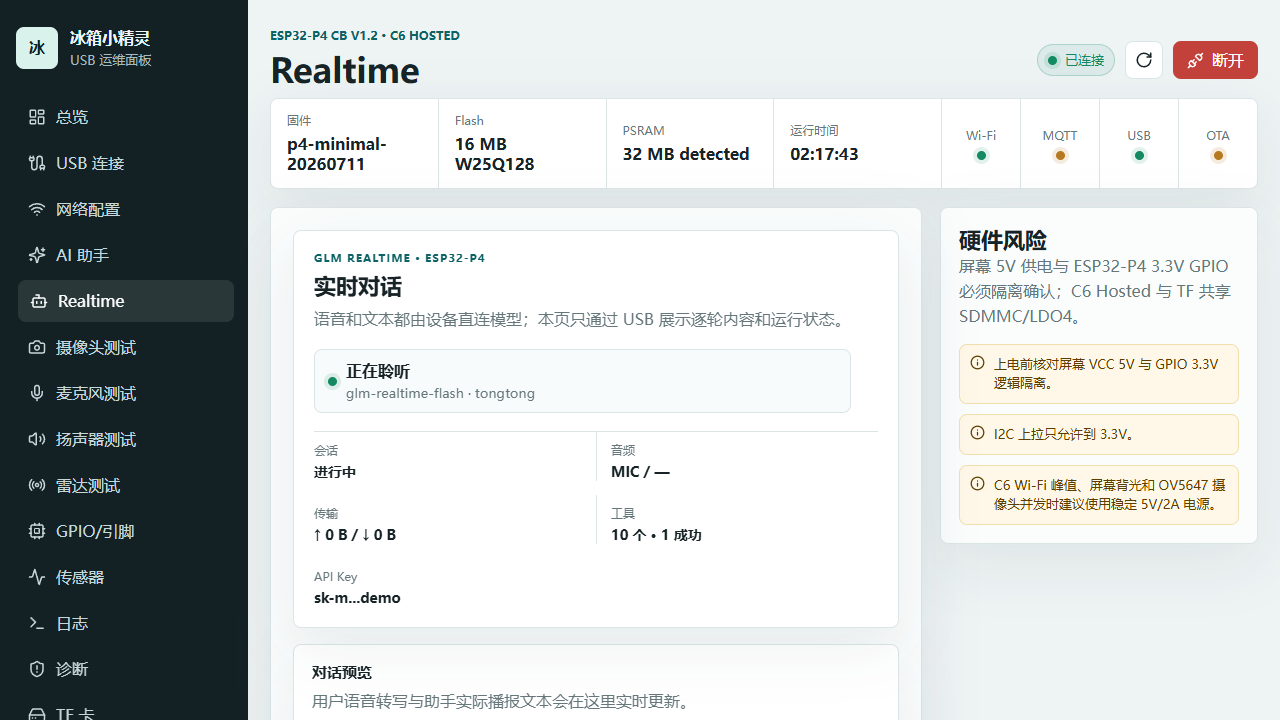
doc/assets/web-console.png
