the-snowpear/fridge_spirit/doc/INMP441麦克风模块/测试代码/接线说明.png

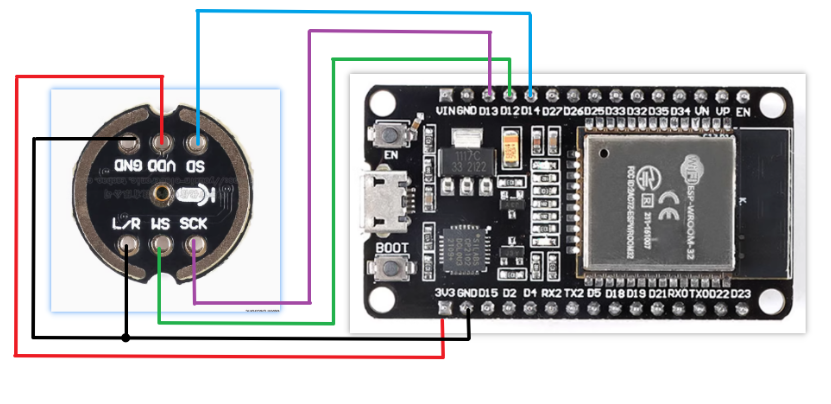
doc/INMP441麦克风模块/测试代码/接线说明.png
