the-snowpear/fridge_spirit/doc/嵌入式软件竖屏架构图.png

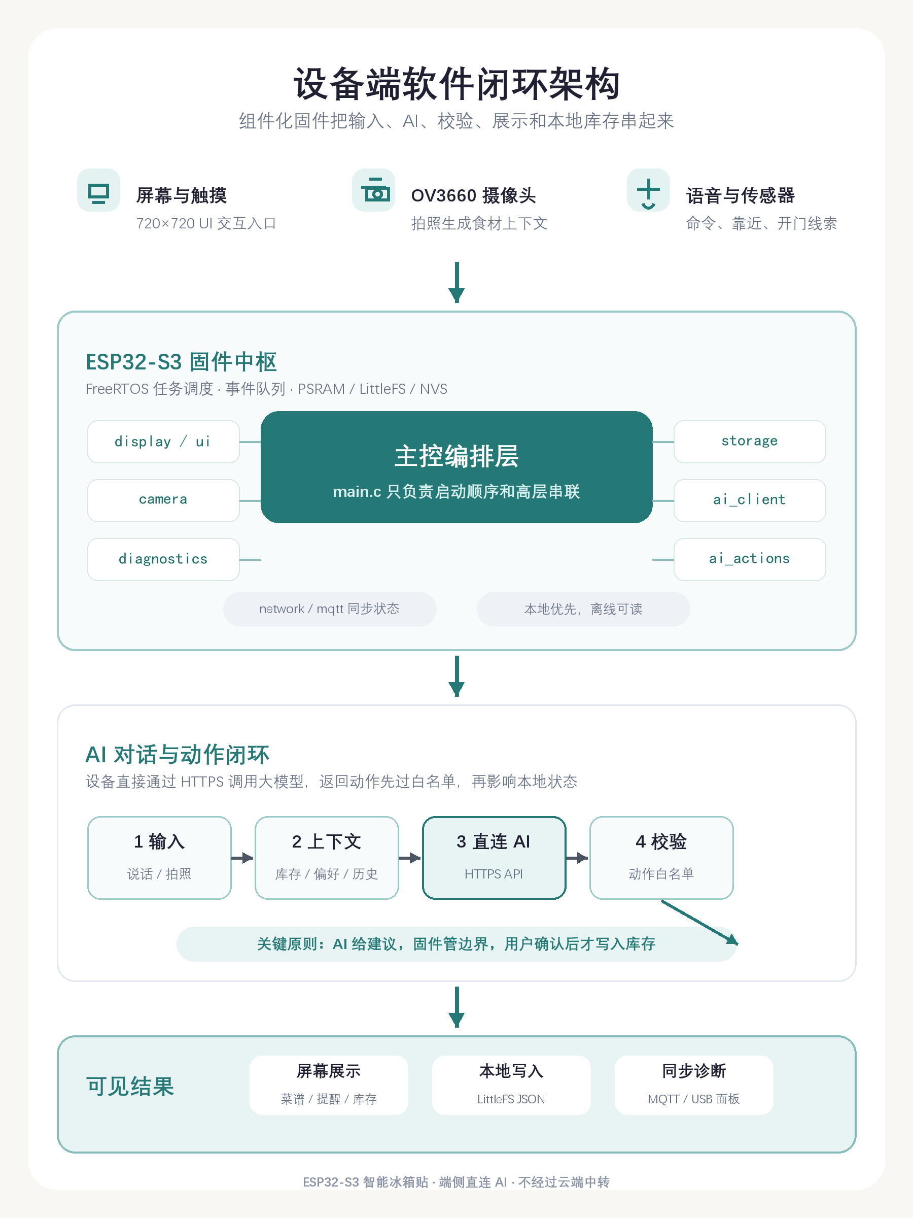
doc/嵌入式软件竖屏架构图.png
