the-snowpear/fridge_spirit/ui-reference/ver2/screenshot/2.png

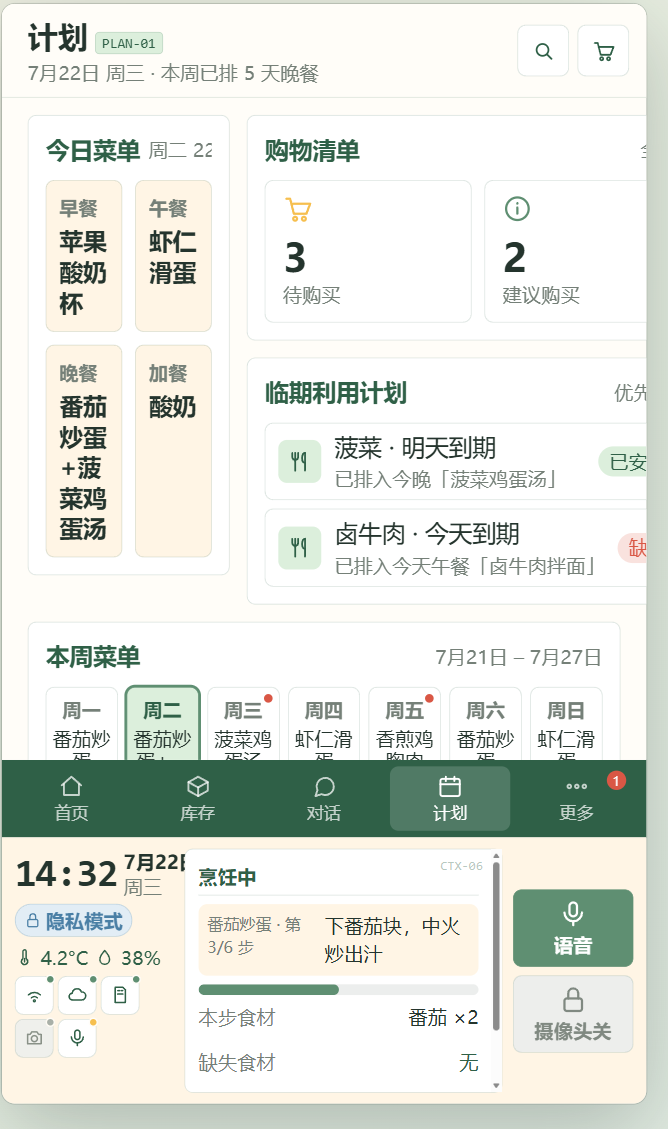
ui-reference/ver2/screenshot/2.png
