the-snowpear/fridge_spirit/model/ver3/装配体2.SLDASM

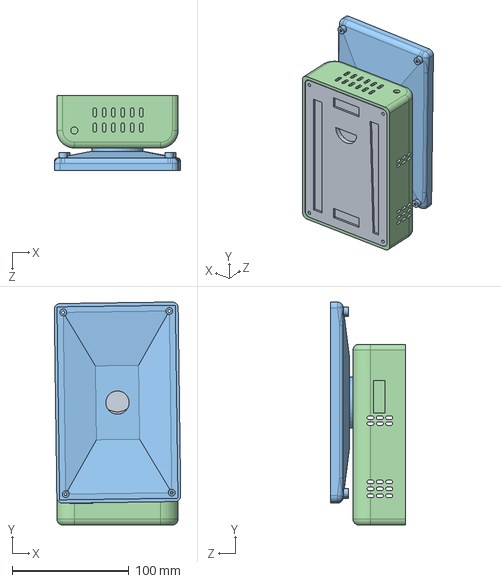
[picture p35: CAD file, 2026-10-28]
model/ver3/装配体2.SLDASM
108.5 x 191.2 x 64.3 mm
