the-snowpear/fridge_spirit/model/ver3/固定板.SLDPRT

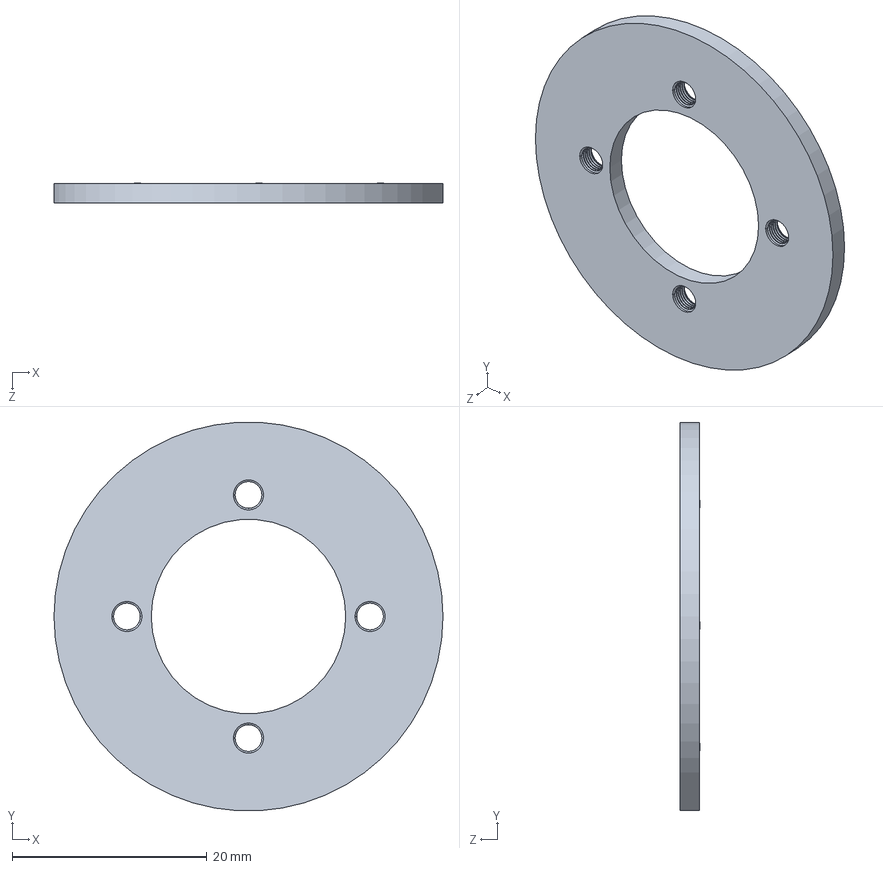
[picture p36: CAD file, 2026-10-28]
model/ver3/固定板.SLDPRT
40.0 x 39.9 x 2.08 mm
