the-snowpear/fridge_spirit/model/上板(4).SLDPRT

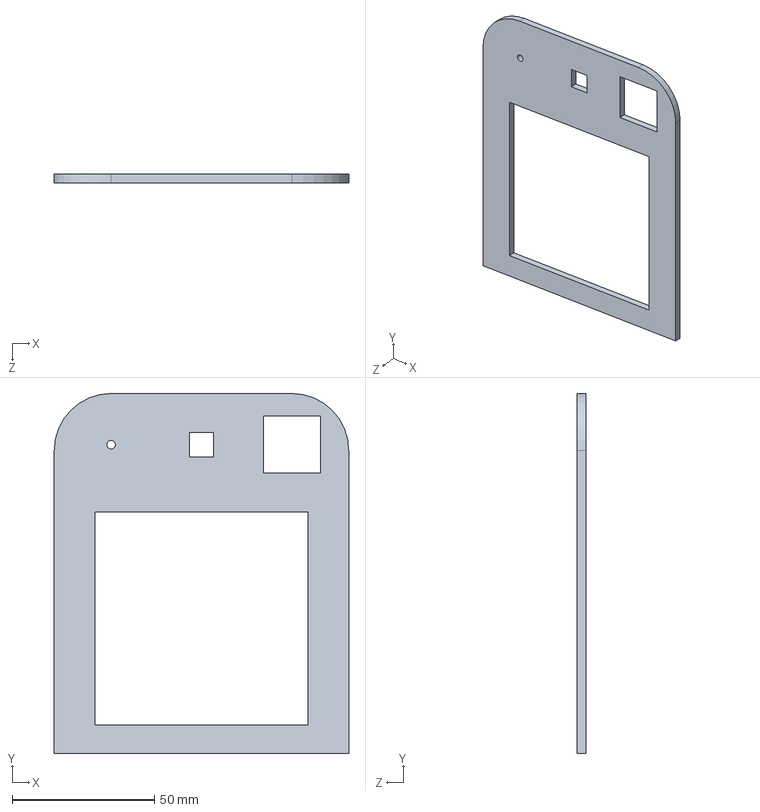
[picture p37: CAD file, 2026-07-02]
model/上板(4).SLDPRT
103.6 x 126.6 x 3.00 mm
