the-snowpear/fridge_spirit/model/ver3/屏幕件.SLDPRT

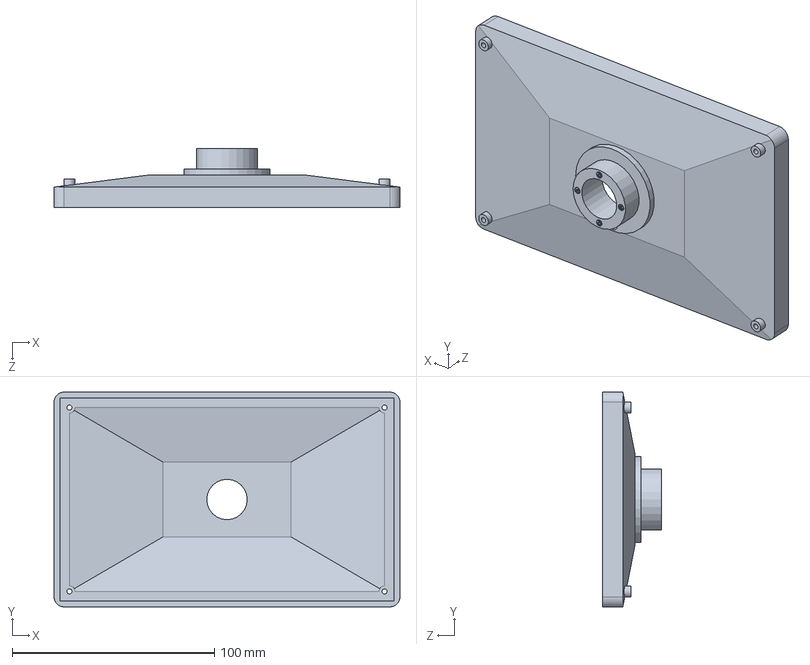
[picture p38: CAD file, 2026-10-28]
model/ver3/屏幕件.SLDPRT
171.2 x 106.3 x 29.0 mm
