the-snowpear/fridge_spirit/model/ver3/箱体.SLDPRT

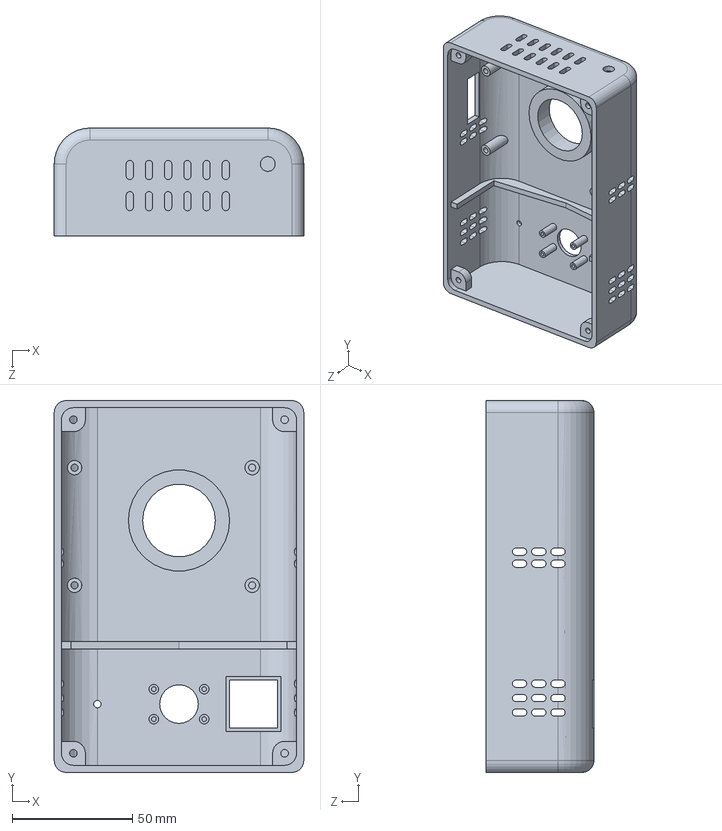
[picture p39: CAD file, 2026-10-28]
model/ver3/箱体.SLDPRT
104.0 x 155.0 x 45.0 mm
