the-snowpear/fridge_spirit/model/ver3/背板.SLDPRT

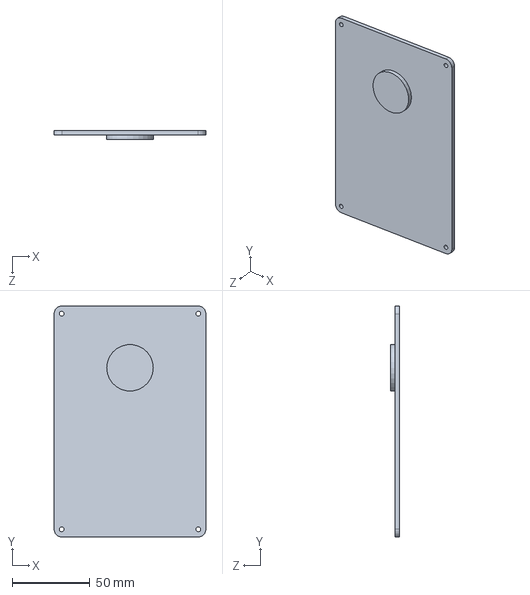
[picture p40: CAD file, 2026-10-28]
model/ver3/背板.SLDPRT
97.8 x 148.8 x 6.00 mm
