the-snowpear/fridge_spirit/model/legacy/底板(4).SLDPRT

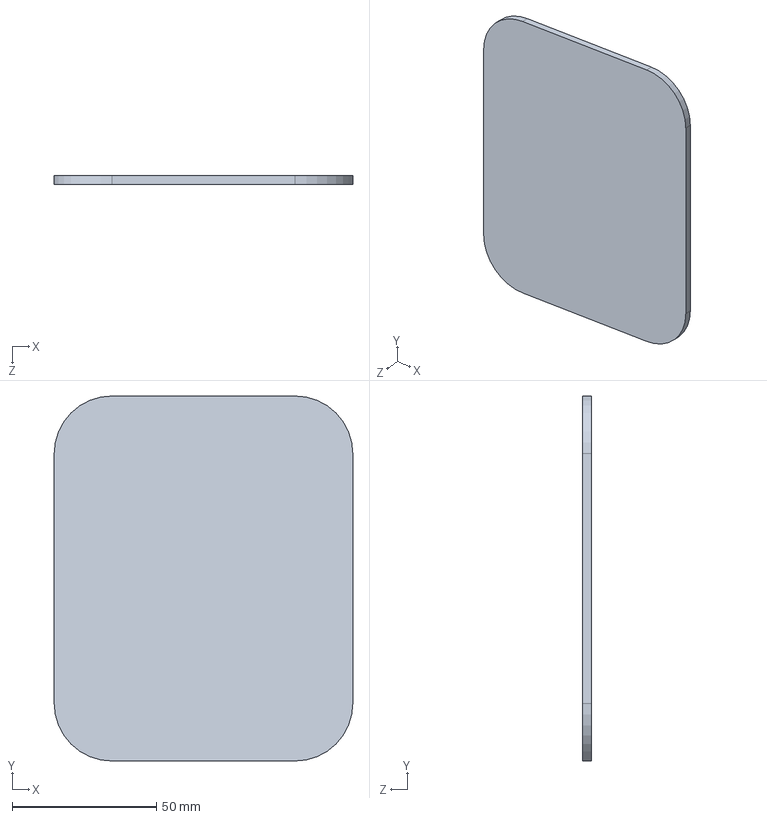
[picture p41: CAD file, 2026-10-28, an earlier design]
model/legacy/底板(4).SLDPRT
103.6 x 126.6 x 3.00 mm
