the-snowpear/fridge_spirit/model/legacy/箱体(4).SLDPRT

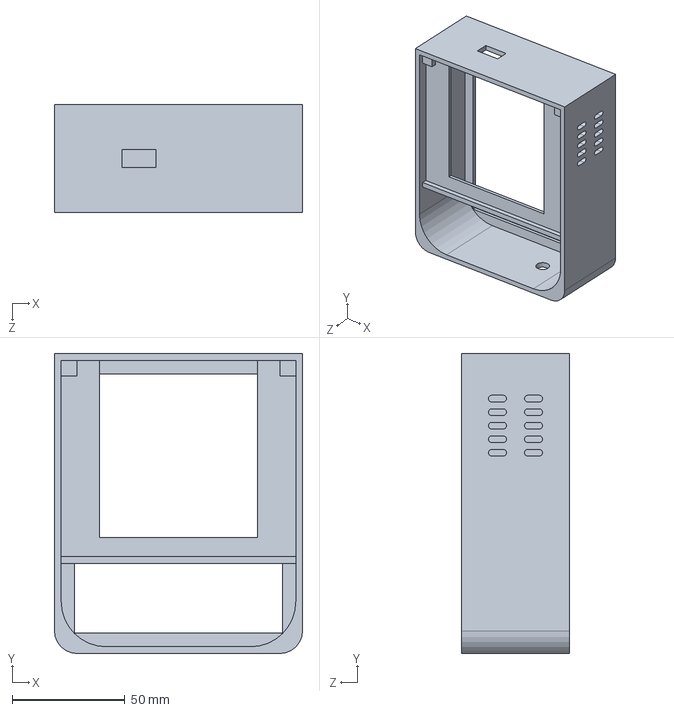
[picture p42: CAD file, 2026-10-28, an earlier design]
model/legacy/箱体(4).SLDPRT
110.0 x 133.0 x 48.0 mm
