the-snowpear/fridge_spirit/(list of files, cad)

Other CAD files:
model/ver3/固定板.STL
model/ver3/屏幕件.STL
model/ver3/箱体.STL
model/ver3/背板.STL
