the-snowpear/fridge_spirit/doc/野火小智【姿态传感器_MPU6050】模块_20260206/1-硬件资料_参考资料_模块手册/原理图_尺寸图/野火小智MPU6050六轴姿态模块尺寸.pdf

# ART FILM - ADT

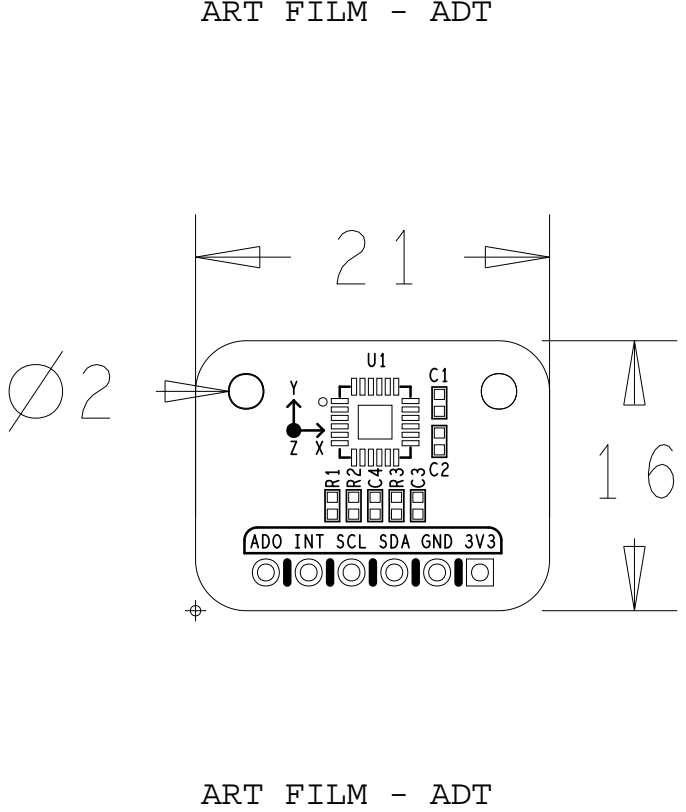
[picture p44: page 1]

ADO INT SCL SDA GND 3V3
