the-snowpear/fridge_spirit/doc/野火小智【姿态传感器_MPU6050】模块_20260206/2-配套例程_接线说明/F407_霸天虎开发板/HAL库/对应教程例程/程序_4.3寸_NT35510/1.MPU6050基本数据读取_(硬件I2C)/User/main.c

/**
  ******************************************************************************
  * @file    main.c
  * @author  fire
  * @version V1.0
  * @date    2017-xx-xx
  * @brief   GPIO输出--使用固件库点亮LED灯
  ******************************************************************************
  * @attention
  *
  * 实验平台:野火  STM32 F407 开发板 
  * 论坛    :http://www.firebbs.cn
  * 淘宝    :http://firestm32.taobao.com
  *
  ******************************************************************************
  */
#include "main.h"
#include "stm32f4xx.h"
#include "./usart/bsp_debug_usart.h"
#include "./led/bsp_led.h"
#include "./i2c/i2c.h"
#include "./mpu6050/mpu6050.h"

//设置是否使用LCD进行显示，不需要的话把这个宏注释掉即可
#define USE_LCD_DISPLAY

#ifdef USE_LCD_DISPLAY
 #include "./lcd/bsp_nt35510_lcd.h"
#endif

/*简单任务管理*/
uint32_t Task_Delay[NumOfTask]={0};

/**
  * @brief  主函数
  * @param  无
  * @retval 无
  */
int main(void)
{
	
	short Acel[3];
	short Gyro[3];
	float Temp;
	
  /* 系统时钟初始化成168MHz */
  SystemClock_Config();
  LED_GPIO_Config();
#ifdef USE_LCD_DISPLAY	
		 /*初始化液晶屏*/
	NT35510_Init ();         //LCD 初始化
	
	//其中0、3、5、6 模式适合从左至右显示文字，
	//不推荐使用其它模式显示文字	其它模式显示文字会有镜像效果			
	//其中 6 模式为大部分液晶例程的默认显示方向  
  NT35510_GramScan ( 6 );
#endif
	
  /*初始化USART1*/
  DEBUG_USART_Config(); 
	//初始化 I2C
	I2cMaster_Init(); 
	printf("\r\n 欢迎使用野火  STM32 F407 开发板。\r\n");		 
	printf("\r\n 这是一个I2C外设(AT24C02)读写测试例程 \r\n");
 	 //MPU6050初始化
	MPU6050_Init();
	//检测MPU6050
	if (MPU6050ReadID() == 1)
	{	
		while(1)
		{
			if(Task_Delay[0]==TASK_ENABLE)
			{
				LED2_TOGGLE;
				Task_Delay[0]=1000;
			}
			if(Task_Delay[1]==0)
			{
				MPU6050ReadAcc(Acel);
				printf("加速度：%8d%8d%8d",Acel[0],Acel[1],Acel[2]);
				MPU6050ReadGyro(Gyro);
				printf("    陀螺仪%8d%8d%8d",Gyro[0],Gyro[1],Gyro[2]);
				MPU6050_ReturnTemp(&Temp);
				printf("    温度%8.2f\r\n",Temp);				
				#ifdef USE_LCD_DISPLAY	
					{
						char cStr [ 70 ];
						sprintf ( cStr, "Acc  :%6d%6d%6d",Acel[0],Acel[1],Acel[2] );	//加速度原始数据


						NT35510_DispStringLine_EN(LINE(7),cStr);			

						sprintf ( cStr, "Gyro :%6d%6d%6d",Gyro[0],Gyro[1],Gyro[2] );	//角原始数据

						NT35510_DispStringLine_EN(LINE(8),cStr);			

						sprintf ( cStr, "Tem  :%6.2f",Temp );	//温度值
						NT35510_DispStringLine_EN(LINE(9),cStr);			
					}
				#endif		
				Task_Delay[1]=500; //更新一次数据，可根据自己的需求，提高采样频率，如100ms采样一次	
			}
		}

	}
	else
	{
			printf("\r\n没有检测到MPU6050传感器！\r\n");
			LED_RED; 
			#ifdef USE_LCD_DISPLAY			
				/*设置字体颜色及字体的背景颜色*/
				LCD_SetColors(BLUE,BLACK);	
     //野火自带的16*24显示
				NT35510_DispStringLine_EN(LINE(4),"No MPU6050 detected! ");			
		//野火自带的16*24显示
				NT35510_DispStringLine_EN(LINE(5),"Please check the hardware connection! ");			
			#endif
		while(1);	
	}
}


/**
  * @brief  System Clock Configuration
  *         The system Clock is configured as follow : 
  *            System Clock source            = PLL (HSE)
  *            SYSCLK(Hz)                     = 168000000
  *            HCLK(Hz)                       = 168000000
  *            AHB Prescaler                  = 1
  *            APB1 Prescaler                 = 4
  *            APB2 Prescaler                 = 2
  *            HSE Frequency(Hz)              = 8000000
  *            PLL_M                          = 25
  *            PLL_N                          = 336
  *            PLL_P                          = 2
  *            PLL_Q                          = 7
  *            VDD(V)                         = 3.3
  *            Main regulator output voltage  = Scale1 mode
  *            Flash Latency(WS)              = 5
  * @param  None
  * @retval None
  */
 void SystemClock_Config(void)
{
  RCC_ClkInitTypeDef RCC_ClkInitStruct;
  RCC_OscInitTypeDef RCC_OscInitStruct;

  /* Enable Power Control clock */
  __HAL_RCC_PWR_CLK_ENABLE();
  
  /* The voltage scaling allows optimizing the power consumption when the device is 
     clocked below the maximum system frequency, to update the voltage scaling value 
     regarding system frequency refer to product datasheet.  */
  __HAL_PWR_VOLTAGESCALING_CONFIG(PWR_REGULATOR_VOLTAGE_SCALE1);
  
  /* Enable HSE Oscillator and activate PLL with HSE as source */
  RCC_OscInitStruct.OscillatorType = RCC_OSCILLATORTYPE_HSE;
  RCC_OscInitStruct.HSEState = RCC_HSE_ON;
  RCC_OscInitStruct.PLL.PLLState = RCC_PLL_ON;
  RCC_OscInitStruct.PLL.PLLSource = RCC_PLLSOURCE_HSE;
  RCC_OscInitStruct.PLL.PLLM = 25;
  RCC_OscInitStruct.PLL.PLLN = 336;
  RCC_OscInitStruct.PLL.PLLP = RCC_PLLP_DIV2;
  RCC_OscInitStruct.PLL.PLLQ = 7;
  if(HAL_RCC_OscConfig(&RCC_OscInitStruct) != HAL_OK)
  {
    while(1) {};
  }
  
  /* Select PLL as system clock source and configure the HCLK, PCLK1 and PCLK2 
     clocks dividers */
  RCC_ClkInitStruct.ClockType = (RCC_CLOCKTYPE_SYSCLK | RCC_CLOCKTYPE_HCLK | RCC_CLOCKTYPE_PCLK1 | RCC_CLOCKTYPE_PCLK2);
  RCC_ClkInitStruct.SYSCLKSource = RCC_SYSCLKSOURCE_PLLCLK;
  RCC_ClkInitStruct.AHBCLKDivider = RCC_SYSCLK_DIV1;
  RCC_ClkInitStruct.APB1CLKDivider = RCC_HCLK_DIV4;  
  RCC_ClkInitStruct.APB2CLKDivider = RCC_HCLK_DIV2;  
  if(HAL_RCC_ClockConfig(&RCC_ClkInitStruct, FLASH_LATENCY_5) != HAL_OK)
  {
    while(1) {};
  }

  /* STM32F405x/407x/415x/417x Revision Z devices: prefetch is supported  */
  if (HAL_GetREVID() == 0x1001)
  {
    /* Enable the Flash prefetch */
    __HAL_FLASH_PREFETCH_BUFFER_ENABLE();
  }
}

/************************ (C) COPYRIGHT STMicroelectronics *****END OF FILE****/
