the-snowpear/fridge_spirit/components/speaker/fridge_speaker.c

// 冰箱小精灵扬声器测试组件。
// 通过 MAX98357 I2S 数字功放播放云端 TTS 返回的 24kHz/16-bit/mono PCM。
// 硬件注意：MAX98357 VCC 可接 5V，但 BCLK/LRC/DIN/SD/GAIN 只能接 ESP32-S3 的 3.3V 逻辑信号；上电前必须确认共地和扬声器阻抗。
#include "fridge_speaker.h"

#include <ctype.h>
#include <limits.h>
#include <stdio.h>
#include <stdlib.h>
#include <string.h>
#include <time.h>
#include "cJSON.h"
#include "driver/i2s_std.h"
#include "esp_check.h"
#include "esp_crt_bundle.h"
#include "esp_heap_caps.h"
#include "esp_http_client.h"
#include "esp_log.h"
#include "esp_timer.h"

// ESP-IDF 5.5.1 尚未提供专用的 HTTP 响应不完整错误码；用“对端已关闭连接”
// 保持相同的失败/重试语义，同时兼容后续已经定义该错误码的 IDF 版本。
#ifndef ESP_ERR_HTTP_INCOMPLETE_DATA
#define ESP_ERR_HTTP_INCOMPLETE_DATA ESP_ERR_HTTP_CONNECTION_CLOSED
#endif
#include "fridge_i2s_shared.h"
#include "fridge_network.h"
#include "freertos/FreeRTOS.h"
#include "freertos/semphr.h"
#include "freertos/task.h"
#include "nvs.h"

#define SPEAKER_BCLK_GPIO 40
#define SPEAKER_WS_GPIO 41
#define SPEAKER_DOUT_GPIO 39
#define SPEAKER_DMA_DESC_NUM 4
#define SPEAKER_DMA_FRAME_NUM 256
#define SPEAKER_TASK_STACK 4096
#define SPEAKER_HTTP_MAX_BYTES (384 * 1024)
#define SPEAKER_HTTP_READ_CHUNK 4096
#define SPEAKER_HTTP_TX_BUFFER_SIZE 2048
#define SPEAKER_TTS_HTTP_ATTEMPTS 2
#define SPEAKER_BUS_ACQUIRE_TIMEOUT_MS 200
#define TTS_NVS_NAMESPACE "fridge_tts"
#define TTS_NVS_KEY_URL "url"
#define TTS_NVS_KEY_MODEL "model"
#define TTS_NVS_KEY_VOICE "voice"
#define TTS_NVS_KEY_API_KEY "api_key"
#define TTS_NVS_KEY_TIMEOUT "timeout_ms"
#define TTS_NVS_KEY_UPDATED_MS "updated_ms"
#define TTS_NVS_KEY_VOLUME "volume"
#define TTS_NVS_KEY_ENABLED "enabled"

static const char *TAG = "fridge_speaker";

typedef struct {
    uint8_t *data;
    size_t len;
    size_t cap;
    bool overflow;
    int status;
    uint32_t latency_ms;
    int64_t content_length;
    bool complete;
} speaker_http_buffer_t;

typedef struct {
    bool stream;
    bool include_sample_rate;
    const char *label;
} speaker_tts_request_profile_t;

static i2s_chan_handle_t s_tx_chan;
static SemaphoreHandle_t s_lock;
static TaskHandle_t s_play_task;
static uint8_t *s_audio;
static size_t s_audio_bytes;
static size_t s_played_bytes;
static uint32_t s_duration_ms;
static uint32_t s_latency_ms;
static int s_http_status;
static fridge_speaker_state_t s_state = FRIDGE_SPEAKER_STATE_IDLE;
static char s_model[FRIDGE_TTS_MAX_MODEL_LEN + 1];
static char s_voice[FRIDGE_TTS_MAX_VOICE_LEN + 1];
static char s_error[FRIDGE_TTS_MAX_ERROR_LEN + 1];
static uint8_t s_volume = FRIDGE_SPEAKER_DEFAULT_VOLUME;
static bool s_volume_loaded;
static bool s_tts_enabled = true;
static bool s_tts_enabled_loaded;
static bool s_initialized;
static bool s_i2s_enabled;
static volatile bool s_stop_requested;

static i2s_std_config_t make_speaker_std_config(void)
{
    i2s_std_config_t std_cfg = {
        .clk_cfg = I2S_STD_CLK_DEFAULT_CONFIG(FRIDGE_TTS_SAMPLE_RATE),
        .slot_cfg = I2S_STD_PHILIPS_SLOT_DEFAULT_CONFIG(I2S_DATA_BIT_WIDTH_16BIT, I2S_SLOT_MODE_MONO),
        .gpio_cfg = {
            .mclk = I2S_GPIO_UNUSED,
            .bclk = SPEAKER_BCLK_GPIO,
            .ws = SPEAKER_WS_GPIO,
            .dout = SPEAKER_DOUT_GPIO,
            .din = I2S_GPIO_UNUSED,
            .invert_flags = {
                .mclk_inv = false,
                .bclk_inv = false,
                .ws_inv = false,
            },
        },
    };
    std_cfg.slot_cfg.slot_mask = I2S_STD_SLOT_LEFT;
    return std_cfg;
}

static esp_err_t rebind_speaker_i2s_bus(void)
{
    // 扬声器和 INMP441 共用 GPIO40/41 作为 BCLK/WS。麦克风录音后会把 GPIO matrix
    // 重新指向 RX 通道；播放前再绑定 TX，避免共享时钟线长期停在麦克风配置。
    i2s_std_config_t std_cfg = make_speaker_std_config();
    esp_err_t err = i2s_channel_reconfig_std_clock(s_tx_chan, &std_cfg.clk_cfg);
    if (err != ESP_OK) {
        return err;
    }
    err = i2s_channel_reconfig_std_slot(s_tx_chan, &std_cfg.slot_cfg);
    if (err != ESP_OK) {
        return err;
    }
    return i2s_channel_reconfig_std_gpio(s_tx_chan, &std_cfg.gpio_cfg);
}

static void *speaker_large_alloc(size_t size)
{
    void *ptr = heap_caps_malloc(size, MALLOC_CAP_SPIRAM | MALLOC_CAP_8BIT);
    if (!ptr) {
        ptr = heap_caps_malloc(size, MALLOC_CAP_8BIT);
    }
    return ptr;
}

static void make_key_preview(const char *key, char *out, size_t out_size)
{
    if (!out || out_size == 0) {
        return;
    }
    out[0] = '\0';
    if (!key || key[0] == '\0') {
        return;
    }
    size_t len = strlen(key);
    if (len <= 8) {
        strlcpy(out, "已保存", out_size);
        return;
    }
    snprintf(out, out_size, "%.*s...%s", strncmp(key, "sk-", 3) == 0 ? 3 : 4, key, key + len - 4);
}

static uint32_t clamp_timeout_ms(uint32_t timeout_ms)
{
    if (timeout_ms < 5000) {
        return 5000;
    }
    if (timeout_ms > 90000) {
        return 90000;
    }
    return timeout_ms;
}

static int64_t tts_config_now_ms(void)
{
    time_t now = time(NULL);
    if (now >= 1735689600LL) {
        return (int64_t)now * 1000;
    }
    return esp_timer_get_time() / 1000;
}

static int64_t load_tts_updated_ms(void)
{
    nvs_handle_t handle;
    esp_err_t err = nvs_open(TTS_NVS_NAMESPACE, NVS_READONLY, &handle);
    if (err != ESP_OK) {
        return 0;
    }
    int64_t updated_ms = 0;
    (void)nvs_get_i64(handle, TTS_NVS_KEY_UPDATED_MS, &updated_ms);
    nvs_close(handle);
    return updated_ms > 0 ? updated_ms : 0;
}

static uint8_t clamp_volume(uint8_t percent)
{
    return percent > 100 ? 100 : percent;
}

static void set_state(fridge_speaker_state_t state, const char *error)
{
    xSemaphoreTake(s_lock, portMAX_DELAY);
    s_state = state;
    strlcpy(s_error, error ? error : "", sizeof(s_error));
    xSemaphoreGive(s_lock);
}

static void read_nvs_string(nvs_handle_t handle, const char *key, char *out, size_t out_size, const char *fallback)
{
    size_t len = out_size;
    if (!out || out_size == 0 || nvs_get_str(handle, key, out, &len) != ESP_OK) {
        if (out && out_size > 0) {
            strlcpy(out, fallback ? fallback : "", out_size);
        }
    }
}

static esp_err_t load_tts_config(fridge_tts_config_update_t *config)
{
    ESP_RETURN_ON_FALSE(config, ESP_ERR_INVALID_ARG, TAG, "config is NULL");
    memset(config, 0, sizeof(*config));
    strlcpy(config->api_base_url, FRIDGE_TTS_DEFAULT_URL, sizeof(config->api_base_url));
    strlcpy(config->model, FRIDGE_TTS_DEFAULT_MODEL, sizeof(config->model));
    strlcpy(config->voice, FRIDGE_TTS_DEFAULT_VOICE, sizeof(config->voice));
    config->timeout_ms = FRIDGE_TTS_DEFAULT_TIMEOUT_MS;

    nvs_handle_t handle;
    esp_err_t err = nvs_open(TTS_NVS_NAMESPACE, NVS_READONLY, &handle);
    if (err == ESP_ERR_NVS_NOT_FOUND) {
        return ESP_OK;
    }
    ESP_RETURN_ON_ERROR(err, TAG, "open TTS NVS failed");
    read_nvs_string(handle, TTS_NVS_KEY_URL, config->api_base_url, sizeof(config->api_base_url), FRIDGE_TTS_DEFAULT_URL);
    read_nvs_string(handle, TTS_NVS_KEY_MODEL, config->model, sizeof(config->model), FRIDGE_TTS_DEFAULT_MODEL);
    read_nvs_string(handle, TTS_NVS_KEY_VOICE, config->voice, sizeof(config->voice), FRIDGE_TTS_DEFAULT_VOICE);
    size_t key_len = sizeof(config->api_key);
    if (nvs_get_str(handle, TTS_NVS_KEY_API_KEY, config->api_key, &key_len) == ESP_OK && config->api_key[0] != '\0') {
        config->update_api_key = true;
    }
    uint32_t timeout_ms = FRIDGE_TTS_DEFAULT_TIMEOUT_MS;
    if (nvs_get_u32(handle, TTS_NVS_KEY_TIMEOUT, &timeout_ms) == ESP_OK) {
        config->timeout_ms = clamp_timeout_ms(timeout_ms);
    }
    int64_t updated_ms = 0;
    if (nvs_get_i64(handle, TTS_NVS_KEY_UPDATED_MS, &updated_ms) == ESP_OK && updated_ms > 0) {
        config->config_updated_at_ms = updated_ms;
    }
    nvs_close(handle);
    return ESP_OK;
}

static uint8_t load_saved_volume(void)
{
    uint8_t volume = FRIDGE_SPEAKER_DEFAULT_VOLUME;
    nvs_handle_t handle;
    esp_err_t err = nvs_open(TTS_NVS_NAMESPACE, NVS_READONLY, &handle);
    if (err == ESP_OK) {
        (void)nvs_get_u8(handle, TTS_NVS_KEY_VOLUME, &volume);
        nvs_close(handle);
    }
    return clamp_volume(volume);
}

static esp_err_t save_volume(uint8_t volume)
{
    nvs_handle_t handle;
    ESP_RETURN_ON_ERROR(nvs_open(TTS_NVS_NAMESPACE, NVS_READWRITE, &handle), TAG, "open TTS volume NVS failed");
    esp_err_t err = nvs_set_u8(handle, TTS_NVS_KEY_VOLUME, clamp_volume(volume));
    if (err == ESP_OK) {
        err = nvs_commit(handle);
    }
    nvs_close(handle);
    return err;
}

static bool load_saved_tts_enabled(void)
{
    uint8_t enabled = 1;
    nvs_handle_t handle;
    esp_err_t err = nvs_open(TTS_NVS_NAMESPACE, NVS_READONLY, &handle);
    if (err == ESP_OK) {
        (void)nvs_get_u8(handle, TTS_NVS_KEY_ENABLED, &enabled);
        nvs_close(handle);
    }
    return enabled != 0;
}

static esp_err_t save_tts_enabled(bool enabled)
{
    nvs_handle_t handle;
    ESP_RETURN_ON_ERROR(nvs_open(TTS_NVS_NAMESPACE, NVS_READWRITE, &handle), TAG, "open TTS enable NVS failed");
    esp_err_t err = nvs_set_u8(handle, TTS_NVS_KEY_ENABLED, enabled ? 1 : 0);
    if (err == ESP_OK) {
        err = nvs_commit(handle);
    }
    nvs_close(handle);
    return err;
}

static void scale_pcm16(uint8_t *data, size_t len, uint8_t volume)
{
    // MAX98357 没有数字音量寄存器，这里在 I2S 写入前按百分比缩放 16-bit PCM。
    int16_t *samples = (int16_t *)data;
    size_t count = len / sizeof(int16_t);
    for (size_t i = 0; i < count; i++) {
        int32_t scaled = ((int32_t)samples[i] * (int32_t)volume) / 100;
        if (scaled > INT16_MAX) {
            scaled = INT16_MAX;
        } else if (scaled < INT16_MIN) {
            scaled = INT16_MIN;
        }
        samples[i] = (int16_t)scaled;
    }
}

static char *json_escape_alloc(const char *text)
{
    size_t len = 0;
    for (const unsigned char *p = (const unsigned char *)(text ? text : ""); *p; p++) {
        len += (*p == '"' || *p == '\\' || *p == '\n' || *p == '\r' || *p == '\t') ? 2 : 1;
    }
    char *out = calloc(1, len + 1);
    if (!out) {
        return NULL;
    }
    char *w = out;
    for (const unsigned char *p = (const unsigned char *)(text ? text : ""); *p; p++) {
        if (*p == '"') {
            *w++ = '\\';
            *w++ = '"';
        } else if (*p == '\\') {
            *w++ = '\\';
            *w++ = '\\';
        } else if (*p == '\n') {
            *w++ = '\\';
            *w++ = 'n';
        } else if (*p == '\r') {
            *w++ = '\\';
            *w++ = 'r';
        } else if (*p == '\t') {
            *w++ = '\\';
            *w++ = 't';
        } else if (*p < 0x20) {
            *w++ = '?';
        } else {
            *w++ = (char)*p;
        }
    }
    return out;
}

static void normalize_voice_for_model(const fridge_tts_config_update_t *config, char *out, size_t out_size)
{
    // 硅基流动 MOSS-TTSD 要求 voice 使用“模型名:音色名”的完整格式。
    // Web 里如果残留 OpenAI 的 alloy 或只填 alex，这里自动修正，避免云端 400。
    if (!out || out_size == 0) {
        return;
    }
    const bool is_moss = strcmp(config->model, "fnlp/MOSS-TTSD-v0.5") == 0;
    if (config->voice[0] == '\0') {
        strlcpy(out, FRIDGE_TTS_DEFAULT_VOICE, out_size);
        return;
    }
    if (is_moss && strcmp(config->voice, "alloy") == 0) {
        strlcpy(out, FRIDGE_TTS_DEFAULT_VOICE, out_size);
        return;
    }
    if (strchr(config->voice, ':')) {
        strlcpy(out, config->voice, out_size);
        return;
    }
    if (is_moss) {
        strlcpy(out, config->model, out_size);
        strlcat(out, ":", out_size);
        strlcat(out, config->voice, out_size);
        return;
    }
    strlcpy(out, config->voice, out_size);
}

static bool is_moss_tts_model(const char *model)
{
    return model && strcmp(model, "fnlp/MOSS-TTSD-v0.5") == 0;
}

static bool text_has_moss_speaker_prefix(const char *text)
{
    if (!text) {
        return false;
    }
    while (*text && isspace((unsigned char)*text)) {
        text++;
    }
    return strncmp(text, "[S1]", 4) == 0 || strncmp(text, "[S2]", 4) == 0;
}

static char *build_tts_request(const fridge_tts_config_update_t *config,
                               const char *text,
                               const speaker_tts_request_profile_t *profile)
{
    char normalized_voice[FRIDGE_TTS_MAX_VOICE_LEN + 1] = {0};
    normalize_voice_for_model(config, normalized_voice, sizeof(normalized_voice));
    char *model = json_escape_alloc(config->model);
    char *voice = json_escape_alloc(normalized_voice);
    char *input = NULL;
    const bool moss = is_moss_tts_model(config->model);
    const bool stream = profile ? profile->stream : moss;
    const bool include_sample_rate = !profile || profile->include_sample_rate;
    if (moss && !text_has_moss_speaker_prefix(text)) {
        // SiliconFlow 的 MOSS-TTSD 使用 [S1]/[S2] 区分说话人；设备端单人播报默认补 [S1]，
        // 避免普通文本被服务端当作不完整脚本而提前断开连接。
        size_t wrapped_len = strlen(text ? text : "") + 6;
        char *wrapped = calloc(1, wrapped_len);
        if (wrapped) {
            snprintf(wrapped, wrapped_len, "[S1] %s", text ? text : "");
            input = json_escape_alloc(wrapped);
            free(wrapped);
        }
    } else {
        input = json_escape_alloc(text);
    }
    if (!model || !voice || !input) {
        free(model);
        free(voice);
        free(input);
        return NULL;
    }
    size_t body_len = strlen(model) + strlen(voice) + strlen(input) + 180;
    char *body = calloc(1, body_len);
    if (body) {
        if (include_sample_rate) {
            snprintf(body, body_len,
                     "{\"model\":\"%s\",\"voice\":\"%s\",\"input\":\"%s\","
                     "\"response_format\":\"pcm\",\"sample_rate\":%d,\"stream\":%s}",
                     model, voice, input, FRIDGE_TTS_SAMPLE_RATE, stream ? "true" : "false");
        } else {
            snprintf(body, body_len,
                     "{\"model\":\"%s\",\"voice\":\"%s\",\"input\":\"%s\","
                     "\"response_format\":\"pcm\",\"stream\":%s}",
                     model, voice, input, stream ? "true" : "false");
        }
    }
    free(model);
    free(voice);
    free(input);
    return body;
}

static void speaker_set_http_headers(esp_http_client_handle_t client, const char *api_key)
{
    char auth_header[FRIDGE_TTS_MAX_API_KEY_LEN + 16] = {0};
    snprintf(auth_header, sizeof(auth_header), "Bearer %s", api_key);
    esp_http_client_set_header(client, "Accept", "audio/pcm, application/octet-stream, */*");
    esp_http_client_set_header(client, "Accept-Encoding", "identity");
    esp_http_client_set_header(client, "Content-Type", "application/json");
    esp_http_client_set_header(client, "Connection", "close");
    esp_http_client_set_header(client, "User-Agent", "fridge-spirit-esp32s3/1.0");
    esp_http_client_set_header(client, "Authorization", auth_header);
}

static esp_err_t speaker_tts_http_download_once(const fridge_tts_config_update_t *config,
                                                const char *request_body,
                                                const char *profile_label,
                                                speaker_http_buffer_t *rx)
{
    ESP_RETURN_ON_FALSE(config && request_body && rx && rx->data, ESP_ERR_INVALID_ARG, TAG, "invalid TTS download args");
    rx->len = 0;
    rx->overflow = false;
    rx->status = 0;
    rx->latency_ms = 0;
    rx->content_length = -1;
    rx->complete = false;

    esp_http_client_config_t http_config = {
        .url = config->api_base_url,
        .method = HTTP_METHOD_POST,
        .timeout_ms = (int)clamp_timeout_ms(config->timeout_ms),
        .crt_bundle_attach = esp_crt_bundle_attach,
        .buffer_size = 4096,
        .buffer_size_tx = SPEAKER_HTTP_TX_BUFFER_SIZE,
    };
    esp_http_client_handle_t client = esp_http_client_init(&http_config);
    if (!client) {
        return ESP_FAIL;
    }
    speaker_set_http_headers(client, config->api_key);

    int64_t start_us = esp_timer_get_time();
    ESP_LOGI(TAG,
             "TTS HTTP request: profile=%s model=%s voice=%s body=%u timeout=%ums",
             profile_label ? profile_label : "default",
             config->model,
             config->voice,
             (unsigned)strlen(request_body),
             (unsigned)clamp_timeout_ms(config->timeout_ms));
    esp_err_t err = esp_http_client_open(client, (int)strlen(request_body));
    if (err == ESP_OK) {
        int written = esp_http_client_write(client, request_body, (int)strlen(request_body));
        if (written < 0 || written != (int)strlen(request_body)) {
            ESP_LOGW(TAG, "TTS HTTP write failed: written=%d expected=%u", written, (unsigned)strlen(request_body));
            err = ESP_FAIL;
        }
    } else {
        ESP_LOGW(TAG, "TTS HTTP open failed: %s", esp_err_to_name(err));
    }

    if (err == ESP_OK) {
        int64_t header_len = esp_http_client_fetch_headers(client);
        if (header_len < 0) {
            ESP_LOGW(TAG, "TTS HTTP fetch headers failed: %lld", (long long)header_len);
            err = (header_len == -ESP_ERR_HTTP_EAGAIN) ? ESP_ERR_TIMEOUT : ESP_FAIL;
        } else {
            rx->content_length = header_len;
            rx->status = esp_http_client_get_status_code(client);
            ESP_LOGI(TAG, "TTS HTTP headers: status=%d content_length=%lld", rx->status, (long long)rx->content_length);
            if (rx->status >= 200 && rx->status < 300 && rx->content_length > (int64_t)rx->cap) {
                rx->overflow = true;
                err = ESP_ERR_NO_MEM;
            }
        }
    }

    if (err == ESP_OK && rx->status >= 200 && rx->status < 300) {
        char *chunk = speaker_large_alloc(SPEAKER_HTTP_READ_CHUNK);
        if (!chunk) {
            err = ESP_ERR_NO_MEM;
        } else {
            const bool streaming_without_length = rx->content_length <= 0;
            esp_log_level_t tls_log = ESP_LOG_NONE;
            esp_log_level_t transport_log = ESP_LOG_NONE;
            esp_log_level_t http_log = ESP_LOG_NONE;
            if (streaming_without_length) {
                // 该 TTS 接口用 TLS close 表示流式音频结束。ESP-IDF 底层会先打 E 级日志，
                // 这里仅在读取这类已确认 2xx 的流式响应期间临时压低相关 tag，避免 Web 面板误判为红色故障。
                tls_log = esp_log_level_get("esp-tls-mbedtls");
                transport_log = esp_log_level_get("transport_base");
                http_log = esp_log_level_get("HTTP_CLIENT");
                esp_log_level_set("esp-tls-mbedtls", ESP_LOG_NONE);
                esp_log_level_set("transport_base", ESP_LOG_NONE);
                esp_log_level_set("HTTP_CLIENT", ESP_LOG_NONE);
            }
            while (rx->len < rx->cap) {
                int read_len = esp_http_client_read(client, chunk, SPEAKER_HTTP_READ_CHUNK);
                if (read_len > 0) {
                    size_t available = rx->cap - rx->len;
                    size_t copy_len = (size_t)read_len;
                    if (copy_len > available) {
                        copy_len = available;
                        rx->overflow = true;
                    }
                    memcpy(rx->data + rx->len, chunk, copy_len);
                    rx->len += copy_len;
                    if (rx->overflow) {
                        err = ESP_ERR_NO_MEM;
                        break;
                    }
                    if (rx->content_length <= 0 && esp_http_client_is_complete_data_received(client)) {
                        ESP_LOGI(TAG, "TTS stream complete after %u bytes", (unsigned)rx->len);
                        break;
                    }
                    continue;
                }
                if (read_len == 0) {
                    break;
                }
                if (read_len == -ESP_ERR_HTTP_EAGAIN) {
                    vTaskDelay(pdMS_TO_TICKS(20));
                    continue;
                }
                if (rx->len > 0 && rx->content_length <= 0) {
                    // SiliconFlow 流式 TTS 返回 200 但不带 Content-Length，服务端以 TLS close 结束音频。
                    // esp_http_client_read 会把这个 close 记为 ESP_FAIL；已收到音频时按正常 EOF 处理。
                    ESP_LOGI(TAG, "TTS stream ended by TLS close after %u bytes", (unsigned)rx->len);
                    break;
                }
                err = ESP_FAIL;
                break;
            }
            if (streaming_without_length) {
                esp_log_level_set("esp-tls-mbedtls", tls_log);
                esp_log_level_set("transport_base", transport_log);
                esp_log_level_set("HTTP_CLIENT", http_log);
            }
            free(chunk);
        }
    } else if (err == ESP_OK) {
        char preview[96] = {0};
        int preview_len = esp_http_client_read_response(client, preview, sizeof(preview) - 1);
        if (preview_len > 0) {
            size_t copy_len = (size_t)preview_len < rx->cap ? (size_t)preview_len : rx->cap;
            memcpy(rx->data, preview, copy_len);
            rx->len = copy_len;
        }
    }

    rx->complete = (err == ESP_OK) &&
                   !rx->overflow &&
                   rx->len > 0 &&
                   (rx->content_length <= 0 || (int64_t)rx->len >= rx->content_length);
    rx->latency_ms = (uint32_t)((esp_timer_get_time() - start_us) / 1000);
    if (err == ESP_OK && rx->status >= 200 && rx->status < 300 && !rx->complete) {
        ESP_LOGW(TAG,
                 "TTS HTTP incomplete on manual read: got=%u expected=%lld complete=%d",
                 (unsigned)rx->len,
                 (long long)rx->content_length,
                 esp_http_client_is_complete_data_received(client));
        err = ESP_ERR_HTTP_INCOMPLETE_DATA;
    }
    esp_http_client_close(client);
    esp_http_client_cleanup(client);
    return err;
}

static esp_err_t speaker_tts_http_download_with_body(const fridge_tts_config_update_t *config,
                                                     const char *request_body,
                                                     const char *profile_label,
                                                     speaker_http_buffer_t *rx)
{
    esp_err_t last_err = ESP_FAIL;
    for (int attempt = 1; attempt <= SPEAKER_TTS_HTTP_ATTEMPTS; attempt++) {
        last_err = speaker_tts_http_download_once(config, request_body, profile_label, rx);
        if (last_err == ESP_OK) {
            if (attempt > 1) {
                ESP_LOGI(TAG, "TTS HTTP retry succeeded, bytes=%u", (unsigned)rx->len);
            }
            return ESP_OK;
        }
        ESP_LOGW(TAG,
                 "TTS HTTP attempt %d/%d failed: %s, status=%d, bytes=%u/%lld",
                 attempt,
                 SPEAKER_TTS_HTTP_ATTEMPTS,
                 esp_err_to_name(last_err),
                 rx->status,
                 (unsigned)rx->len,
                 (long long)rx->content_length);
        if (rx->status >= 400 || rx->overflow || last_err == ESP_ERR_NO_MEM) {
            break;
        }
        vTaskDelay(pdMS_TO_TICKS(350 * attempt));
    }
    return last_err;
}
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
