the-snowpear/fridge_spirit/(commit log)

2026-07-02 S3阶段完整存档：切换 ESP32-P4 开发板前的最终 S3 代码状态
2026-07-02 P4迁移启动：改写 CLAUDE.md/AGENTS.md 引导至 ESP32-P4 CB V1.2，追加进度与记忆记录
2026-07-13 屏幕点亮
2026-08-15 P4 主线阶段性整理：落地 MIPI UI/摄像头/传感器与后端多端同步，并清理仓库杂质。
    停止跟踪 backend/.env，忽略修复报告与探针临时文件；还原被污染的厂商参考资料目录。
2026-10-28 仓库规整与产品级 README：移出 1.8GB 厂商例程包，补真机 UI 截图与仓库说明
    索引只保留工程自身内容：doc/野火小智 MPU6050 例程包与误生成的 shell 镜像目录移出跟踪（本地文件保留），跟踪文件 22330 -> 1924；.gitignore 修正行内注释导致 *.exe 等规则失效的问题。新增 README.md 与 doc/assets 真机截图，未改动源码、sdkconfig、分区表与硬件路径。
2026-10-28 README 界面图改用 ver2 UI 预览，并开源整机结构件模型
    界面图从真机截屏换成 ui-reference/ver2 的 1:1 舞台渲染（横屏 6 张 + 竖屏 2 张），横幅同步重绘，保留 1 张真机截屏作对照；新增 model/ver3（P4 整机装配体、4 个零件、STL、紧固件清单）与 model/legacy（S3 旧箱体归档），补 model/README.md 说明引用关系与打印注意事项。未改动固件、UI 与硬件路径。
